GEVE-VENTILATOR/Mechanical-Design-/Schematics/Capture1.PNG

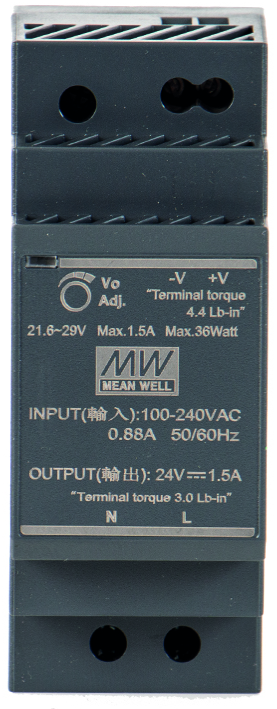
Schematics/Capture1.PNG
