GEVE-VENTILATOR/Mechanical-Design-/Schematics/arduino-a000066.jpg

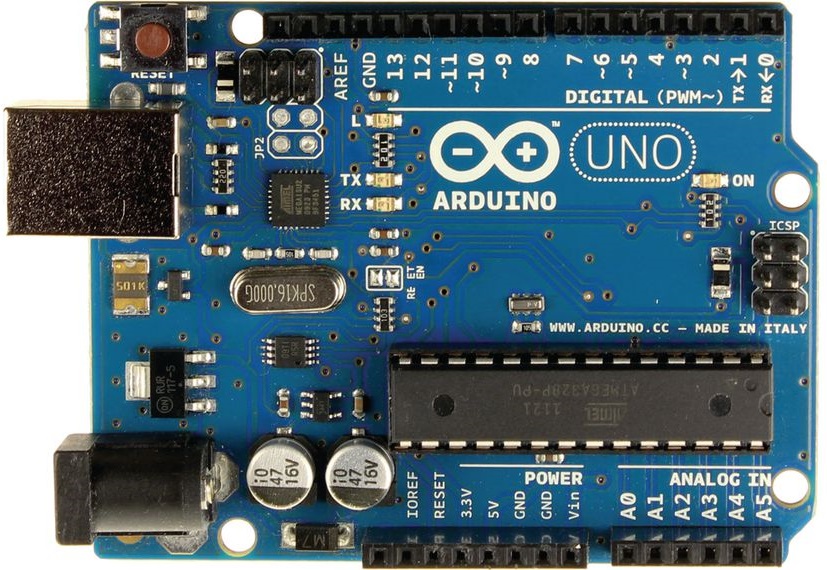
Schematics/arduino-a000066.jpg
