GEVE-VENTILATOR/Mechanical-Design-/README.md

# Mechanical-Design-
This space contains the CAD design of the GEVE Ventilator Project

Here you can find the CAD drawings and the files for the 3D printed parts
