GEVE-VENTILATOR/Mechanical-Design-/CAO/Dossier partage/rob-ceve-p20.pdf

3

317,5

367,5

Plaque de base | Echelle 1:2 | | Dessiné | K. Polte
| | | Date | 05-May-21
| | | Classe
| Fichier de mise en plan | | | ROB-CEVE-P20
hepia | Fichier du modèle | | | ROB-CEVE-P20
| Matière | PMMA
N° de Feuille | 1 | Nbr tot Feuilles | 1 | N° dessin | ROB-CEVE-P20 | Format | A3
