GEVE-VENTILATOR/Mechanical-Design-/CAO/Dossier partage/rob-ceve-p24.pdf

3

5,1

317,5

187,5

5,1

Plaque latérale simple | Echelle 1:2 | | Dessiné | K. Polte
| | | Date | 05-May-21
| | | Classe
| Fichier de mise en plan | | | ROB-CEVE-P24
hepia | Fichier du modèle | | | ROB-CEVE-P24
| Matière | PMMA
N° de Feuille | 1 | Nbr tot Feuilles | 1 | N° dessin | ROB-CEVE-P24 | Format | A4
