GEVE-VENTILATOR/Mechanical-Design-/Schematics/Capture3.PNG

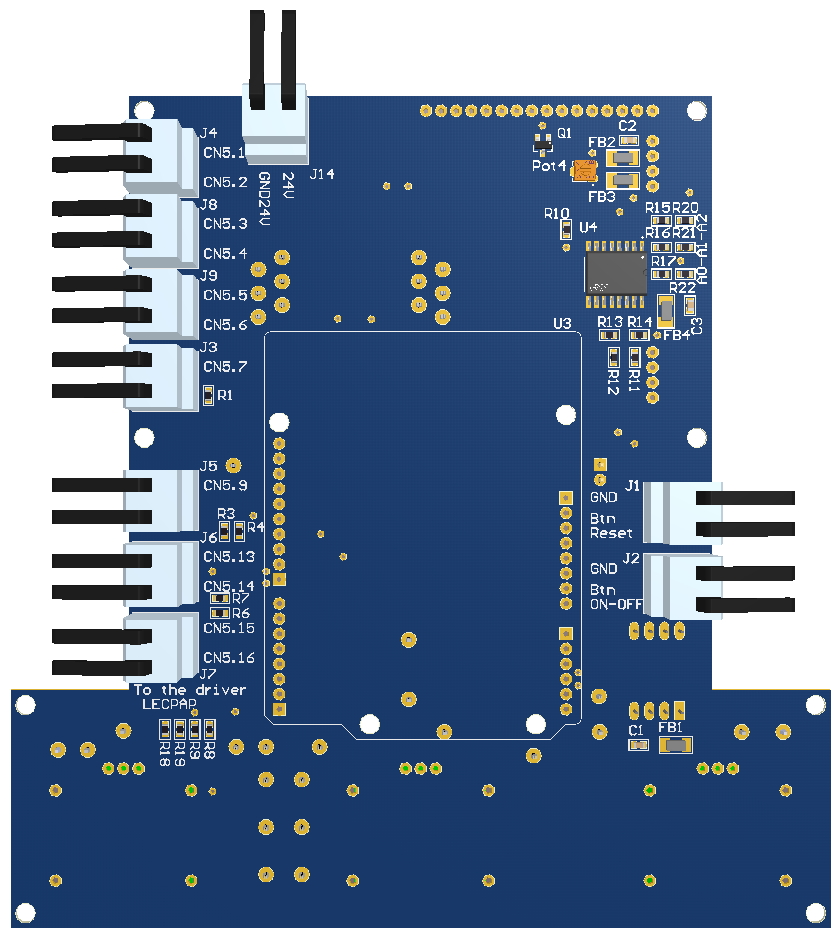
Schematics/Capture3.PNG
