GEVE-VENTILATOR/Mechanical-Design-/Schematics/Capture6.PNG

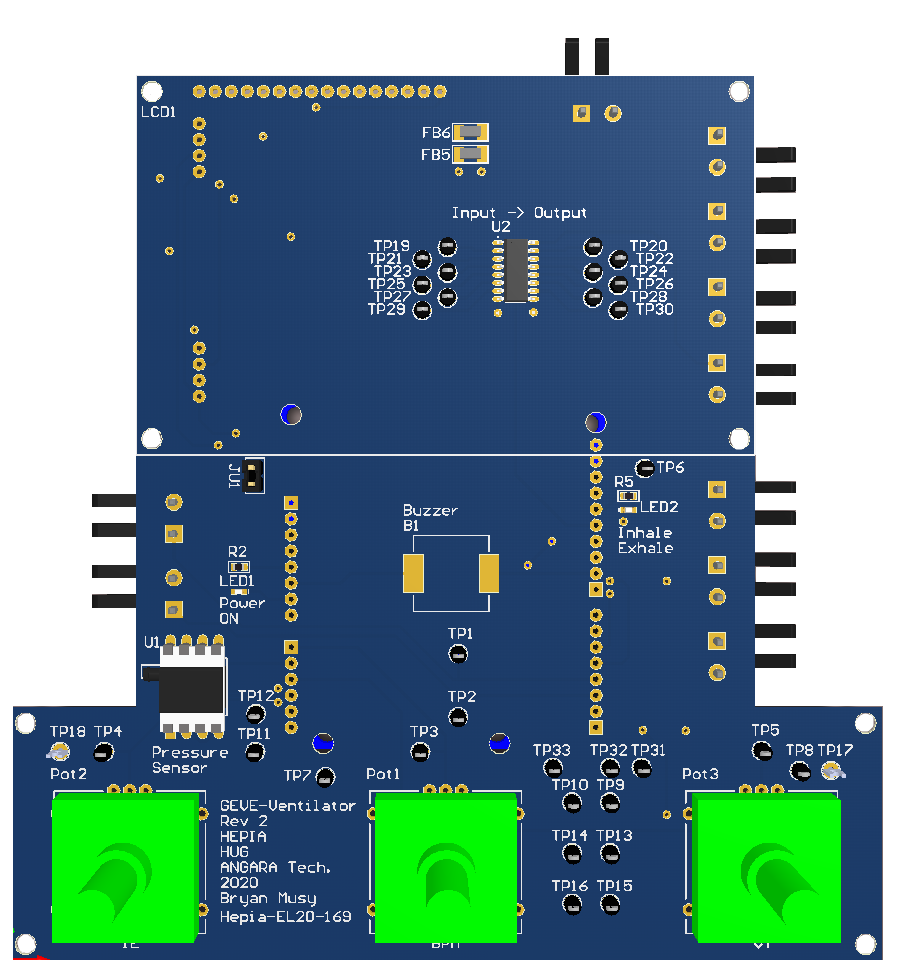
Schematics/Capture6.PNG
