GEVE-VENTILATOR/Mechanical-Design-/Schematics/Capture54.PNG

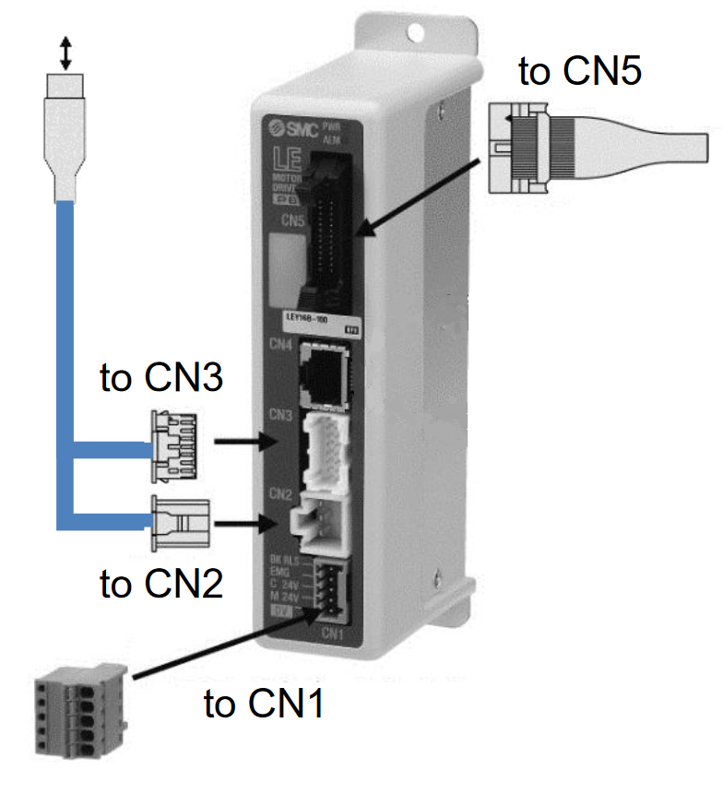
Schematics/Capture54.PNG
