GEVE-VENTILATOR/Mechanical-Design-/Schematics/Capture.PNG

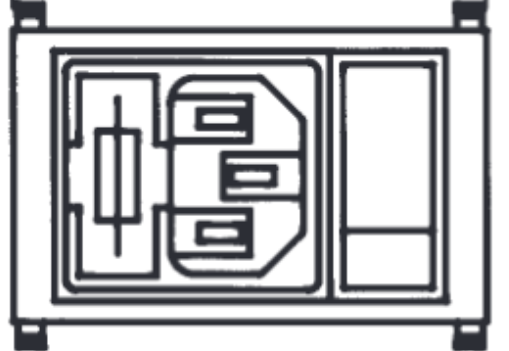
Schematics/Capture.PNG
