GEVE-VENTILATOR/Mechanical-Design-/Schematics/HTB1hoBYaKALL1JjSZFjq6ysqXXaX.jpg

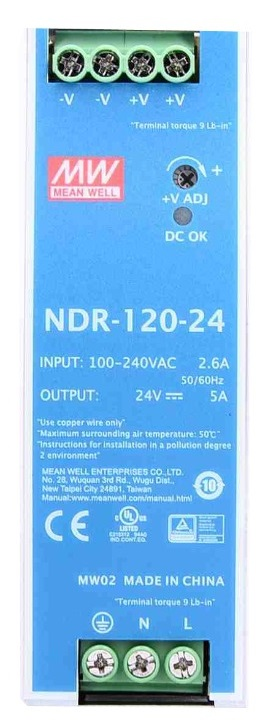
Schematics/HTB1hoBYaKALL1JjSZFjq6ysqXXaX.jpg
