GEVE-VENTILATOR/Mechanical-Design-/Schematics/IDEC-YW1B-A2E10S-30102645-01.jpg

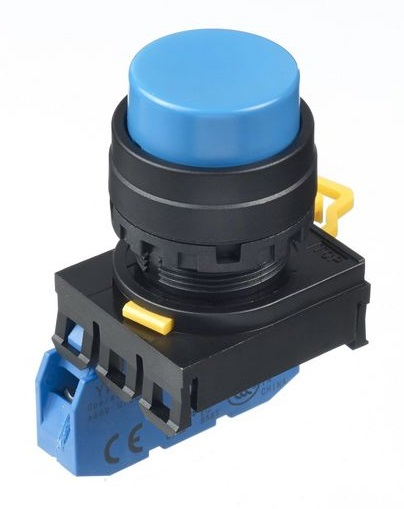
Schematics/IDEC-YW1B-A2E10S-30102645-01.jpg
