GEVE-VENTILATOR/Mechanical-Design-/Schematics/IDEC-YW1L-A2E10Q4G-30102687-01.jpg

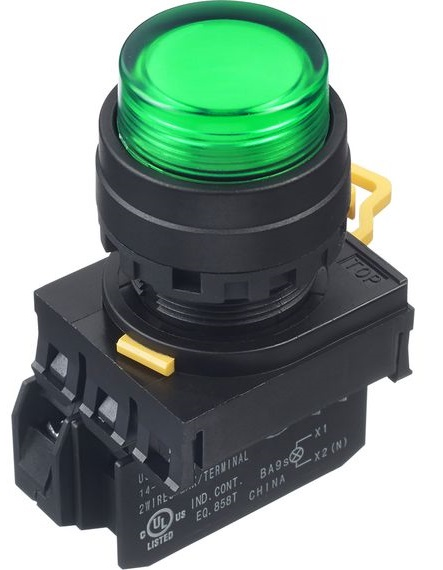
Schematics/IDEC-YW1L-A2E10Q4G-30102687-01.jpg
