GEVE-VENTILATOR/Mechanical-Design-/ListeofComponents.xlsx

Bill of Material for
On 09.11.2020 at 09:12:04
Comment | Pattern | Quantity | Components | Description | Unitary price | Prix | Website | Ref | Link
0R | RES_0603 | 5 | R11, R12, R20, R21, R22 | Thin Film Resistor, Boite Labo 0603, Jumper 0R | 0.09 | 0.45 | Digikey | 311-0.0HRTR-ND | https://www.digikey.ch/product-detail/fr/yageo/RC0603FR-070RL/311-0-0HRTR-ND/1304008
10K | PCW1J-B28-BAB103L | 3 | Pot1, Pot2, Pot3 |  | 4.89 | 14.67 | Digikey | PCW1J-B28-BAB103L-ND | https://www.digikey.ch/products/fr?keywords=PCW1J-B28-BAB103L-ND
10k | RES_0603 | 3 | R15, R16, R17 | Thin Film Resistor, Boite Labo 0603, 10k 1% | 0.09 | 0.27 | Digikey | RNCP0603FTD10K0CT-ND | https://www.digikey.ch/product-detail/fr/stackpole-electronics-inc/RNCP0603FTD10K0/RNCP0603FTD10K0CT-ND/2240478
10k | Trimpot-3313-J1 | 1 | Pot4 | TrimPot SMD 1 Tour 10k 3mm | 1.80 | 1.80 | Digikey | 3313J-103ECT-ND | https://www.digikey.ch/products/fr?keywords=3313J-103ECT-ND
1uF | CAP_0603H0.8 | 3 | C1, C2, C3 | Boite Labo 0603: Ceramic Cap, 1uF, 10%, 50V, CAP_0603H0.8 | 0.09 | 0.27 | Digikey | 738-CML0603Y5V104ZT50VCT-ND | https://www.digikey.ch/product-detail/fr/stackpole-electronics-inc/CML0603Y5V104ZT50V/738-CML0603Y5V104ZT50VCT-ND/10660166
22k | RES_0603 | 4 | R3, R6, R8, R18 | Thin Film Resistor, Boite Labo 0603, 22k 1% | 0.09 | 0.36 | Digikey | RMCF0603FG22K0CT-ND | https://www.digikey.ch/product-detail/fr/stackpole-electronics-inc/RMCF0603FG22K0/RMCF0603FG22K0CT-ND/6053828
3k3 | RES_0603 | 2 | R2, R5 | Thin Film Resistor, Boite Labo 0603, 3k3 1% | 0.09 | 0.18 | Digikey | 311-3.30KHRCT-ND | https://www.digikey.ch/product-detail/fr/yageo/RC0603FR-073K3L/311-3-30KHRCT-ND/730073
4k7 | RES_0603 | 3 | R10, R13, R14 | Thin Film Resistor, Boite Labo 0603, 4k7 1% | 0.09 | 0.27 | Digikey | RMCF0603FT4K70CT-ND | https://www.digikey.ch/product-detail/fr/stackpole-electronics-inc/RMCF0603FT4K70/RMCF0603FT4K70CT-ND/1943033
5k6 | RES_0603 | 5 | R1, R4, R7, R9, R19 | Thin Film Resistor, Boite Labo 0603, 5k6 1% | 0.09 | 0.45 | Digikey | RMCF0603FT5K60CT-ND | https://www.digikey.ch/products/fr?keywords=RMCF0603FT5K60CT-ND
661004152022 |  | 2 | J11, J12 | Connecteur 90 4 fils | 0.68 | 1.36 | Digikey | 732-14127-5-ND | https://www.digikey.ch/products/fr?keywords=661004152022
Connect Alimentation |  | 1 | J13 | Connecteurs d'alimentation Socle | 10.53 | 10.53 | Digikey | 708-1880-ND | https://www.digikey.ch/product-detail/fr/bulgin/BZV01-Z0000-01/708-1880-ND/3961661
ARDUINO_UNO_REV3 | ARDUINO_A000066 | 1 | U3 |  | 20.02 | 20.02 | Digikey | 1050-1024-ND | https://www.digikey.ch/product-detail/fr/arduino/A000066/1050-1024-ND/2784006
AST0250204 | AST0250204 | 9 | J1, J2, J3, J4, J5, J6, J7, J8, J9 |  | 1.50 | 13.50 | Digikey | 1849-1111-ND | https://www.digikey.ch/products/fr?keywords=AST0250204
BC817-25,215 | SOT23-3 | 1 | Q1 | Bipolar NPN, General Purpose, 45V,100MHz, 500mA | 0.13 | 0.13 | Digikey | 1727-2918-1-ND | https://www.digikey.ch/product-detail/fr/nexperia-usa-inc/BC817-25-215/1727-2918-1-ND/763457
BLM31AJ601SN1L | FERRITE_1206_1.1 | 6 | FB1, FB2, FB3, FB4, FB5, FB6 | Chip Ferrite Bead, 1206, 200mA, DCRes=0.90ohm, 100MHz_Res=600ohm | 0.28 | 1.68 | Digikey | 490-11053-1-ND | https://www.digikey.ch/product-detail/fr/murata-electronics/BLM31AJ601SH1L/490-11053-1-ND/5332936
CMT-1203-SMT-TR | CMT-1203-SMT-TR | 1 | B1 |  | 1.64 | 1.64 | Digikey | 102-2197-1-ND | https://www.digikey.ch/product-detail/fr/cui-devices/CMT-1203-SMT-TR/102-2197-1-ND/2364649
Connecteur Male 36 pins |  | 1 | J10 |  | 1.97 | 1.97 | Distrelec | 143-83-922 | https://www.distrelec.ch/fr/890-droit-male-barrette-de-circuit-imprime-trou-traversant-rangees-36-contacts-54mm-pas-preci-dip-890-18-036-10-808/p/14383922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
Fuze |  | 1 | F1 | Fusible 250V 1.25A | 0.70 | 0.70 | Distrelec | 133-52-296 | https://www.distrelec.ch/fr/fusible-20-25a-250v-decalage-temporel-eska-521-018/p/13352296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
LCD2004A | LCD2004 | 1 | LCD1 |  | 8.34 | 8.34 | Banggood | LCD2004 | https://www.banggood.com/Geekcreit-IIC-I2C-2004-204-20-x-4-Character-LCD-Display-Screen-Module-Blue-Geekcreit-for-Arduino-products-that-work-with-official-Ard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
PCF8574T/3,518 | FP-SOT162-1-MFG | 1 | U4 | IC I/O EXPANDER I2C 8B 16SOIC | 1.31 | 1.31 | Digikey | 568-1077-1-ND | https://www.digikey.ch/product-detail/fr/nxp-usa-inc/PCF8574T-3-518/568-1077-1-ND/735791
PREC002SAAN-RC | Jumper_2P_P2.54 | 1 | JU1 | CONN HEADER .100 SNGL STR 2POS" | 0.05 | 0.05 | Digikey | S1012EC-02-ND | https://www.digikey.ch/products/fr?keywords=S1012EC-02-ND
SM0603HCL | LED_0603-12 | 2 | LED1, LED2 | LED red smd 0603 2 mA | 0.57 | 1.14 | Digikey | 492-2524-1-ND | https://www.digikey.ch/product-detail/fr/bivar-inc/SM0603HCL/492-2524-1-ND/9695480
SSCDRNN160MDAA5 | DIP8 SSC Series | 1 | U1 |  | 30.96 | 30.96 | Digikey | 480-5448-ND | https://www.digikey.ch/products/fr?keywords=SSCDRNN160MDAA5
TP_HOOK | TP_HOOK | 31 | TP1, TP2, TP3, TP4, TP5, TP6, TP7, TP8, TP9, TP10, TP11, TP12, TP13, TP14, TP15, TP16, TP19, TP20, TP21, TP22, TP23, TP24, TP25, TP26, TP27, TP28, TP29, TP30, TP31, TP32, TP33 | Test Point Hook Type |  | 0.00
TP_PLATE | TP_PLATE | 2 | TP17, TP18 | Test Point Plate Type (for GND) |  | 0.00
ULN2003ADR | D0016A_M | 1 | U2 | High-Voltage, High-Current Darlington Transistor Array, 0.5 A, 50 V, -20 to 70 degC, 16-Pin SOIC (D), Green (RoHS & no Sb/Br), Tape and Reel | 0.47 | 0.47 | Digikey | 296-1368-1-ND | https://www.digikey.ch/product-detail/fr/texas-instruments/ULN2003ADR/296-1368-1-ND/404968
YW1B-M2E10G |  | 1 | Btn2 | Bouton vert | 9.75 | 9.75 | Distrelec | 301-02-661 | https://www.distrelec.ch/fr/bouton-poussoir-10-600-idec-yw1b-m2e10g/p/30102661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
YW1B-M2E10S |  | 1 | Btn1 | Bouton bleu | 9.75 | 9.75 | Distrelec | 301-02-663 | https://www.distrelec.ch/fr/bouton-poussoir-10-600-idec-yw1b-m2e10s/p/30102663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
3801/04 |  | 1 | Cab1 | Cables plats 4 fils | 0.39 | 0.39 | Digikey | 301-02-663 | https://www.digikey.ch/product-detail/fr/3m/3801-04/3M156838-1-ND/8256317
LECPAP1D |  | 1 | Drive1 | Driver step motor | 265.00 | 265.00 | SMC | LECPAP1D-LEFS25B-200 | https://www.smcpneumatics.com/LECPAP1D-LEFS25B-200.html
NDR-120-24 |  | 1 | Alim1 | Alimentation AC/DC | 32.51 | 32.51 | Digikey | 1866-3518-ND | https://www.digikey.ch/products/fr?keywords=1866-3518-ND
HDR-30-24 |  | 1 | Alim2 | Alimentation DC/DC | 17.21 | 17.21 | Digikey | 1866-2244-ND | https://www.digikey.ch/products/fr?keywords=1866-2244-ND
Pipe Silicone Versilic |  | 1 |  | silicon pipe 1-2 meter | 94.45 | 94.45 | milian | 260001 | https://www.milian.ch/frontoffice/article/260001
Connector Luer |  | 1 |  | Connector Luer | 1.15 | 1.15 | milan | 533057 | https://www.milian.ch/frontoffice/article/533057
 |  |  |  |  |  | 542.73
