GEVE-VENTILATOR/Mechanical-Design-/CAO/Dossier partage/rob-ceve-p32.stp

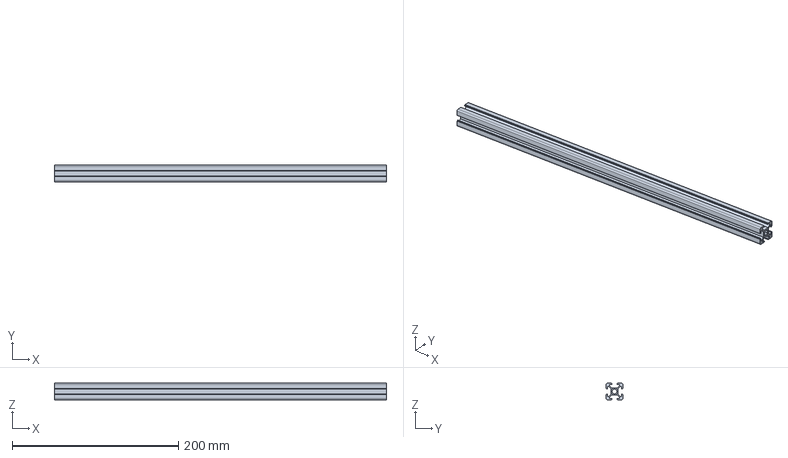
[picture p10: CAD file, 2021-05-17]
CAO/Dossier partage/rob-ceve-p32.stp
400.0 x 20.0 x 20.0 mm
