GEVE-VENTILATOR/Mechanical-Design-/CAO/Respirateur V2/rob-ceve-p31.stp

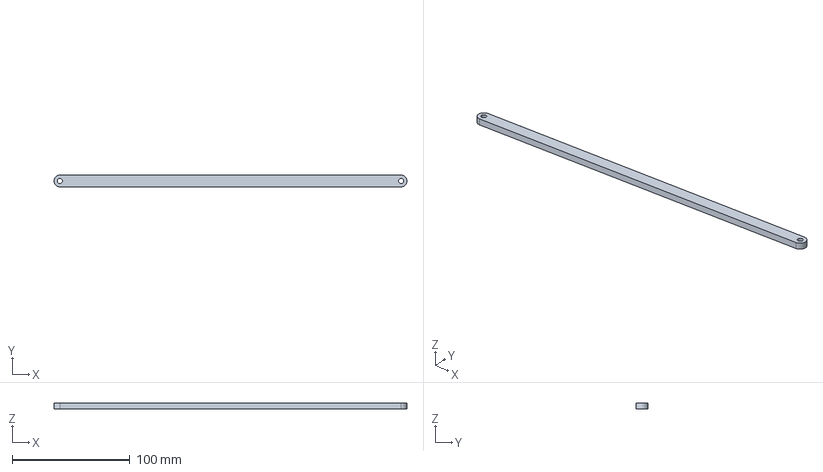
[picture p11: CAD file, 2021-05-17]
CAO/Respirateur V2/rob-ceve-p31.stp
300.0 x 10.0 x 5.00 mm
