GEVE-VENTILATOR/Mechanical-Design-/CAO/sscdrnn160mdaa5.stp

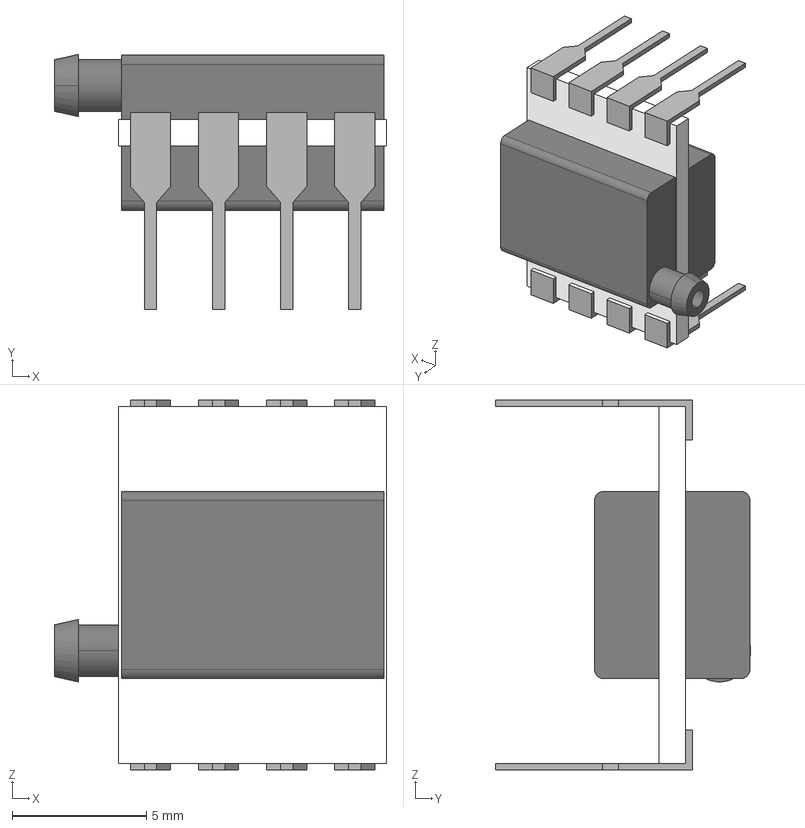
[picture p12: CAD file, 2021-05-17]
CAO/sscdrnn160mdaa5.stp
12.4 x 9.53 x 13.8 mm
