GEVE-VENTILATOR/Mechanical-Design-/CAO/Respirateur V2/rob-ceve-p20.stp

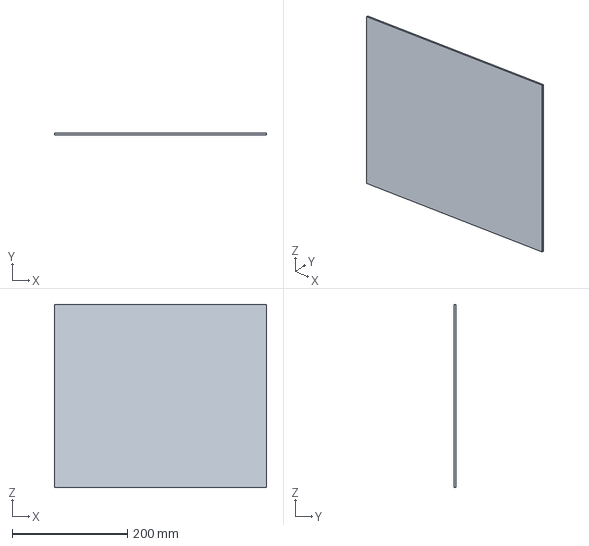
[picture p13: CAD file, 2021-05-17]
CAO/Respirateur V2/rob-ceve-p20.stp
367.5 x 3.00 x 317.5 mm
