GEVE-VENTILATOR/Mechanical-Design-/CAO/Dossier partage/rob-ceve-p08.stp

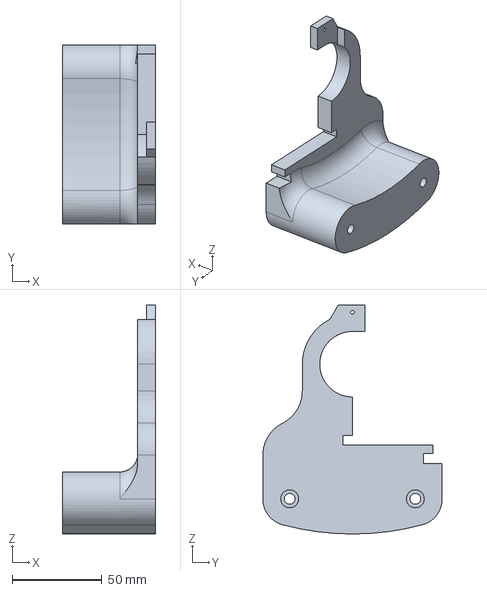
[picture p14: CAD file, 2021-05-17]
CAO/Dossier partage/rob-ceve-p08.stp
52.0 x 100.0 x 127.6 mm
