GEVE-VENTILATOR/Mechanical-Design-/CAO/lcd2004v2.stp

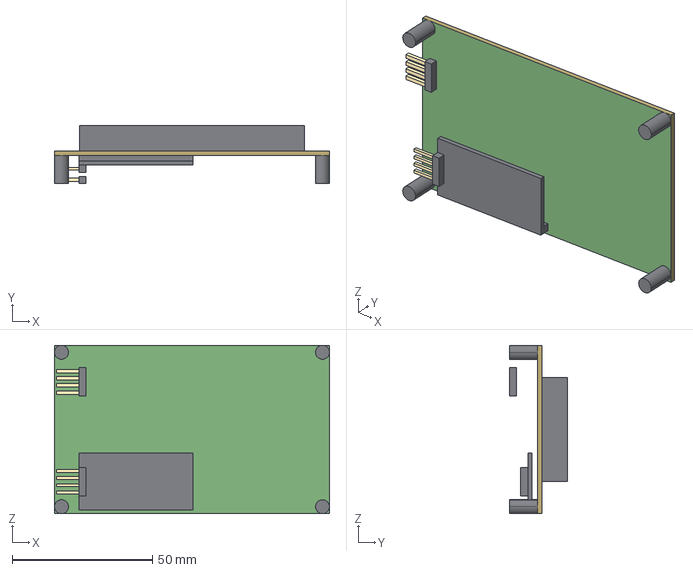
[picture p15: CAD file, 2021-05-17]
CAO/lcd2004v2.stp
98.0 x 20.6 x 60.0 mm
