GEVE-VENTILATOR/Mechanical-Design-/CAO/Respirateur V2/rob-ceve-p25-v2.stl

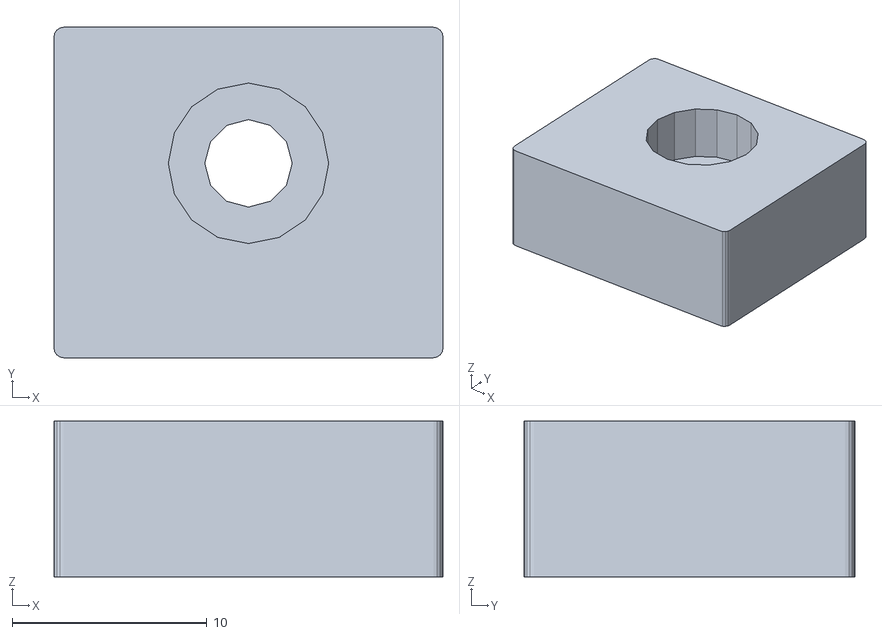
[picture p16: CAD file, 2021-05-17]
CAO/Respirateur V2/rob-ceve-p25-v2.stl
20.0 x 17.0 x 8.00
