GEVE-VENTILATOR/Mechanical-Design-/CAO/Dossier partage/rob-ceve-p09.stp

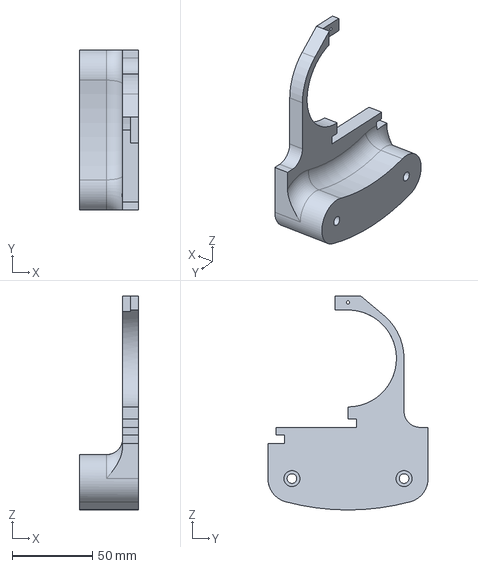
[picture p17: CAD file, 2021-05-17]
CAO/Dossier partage/rob-ceve-p09.stp
37.0 x 100.0 x 133.6 mm
