GEVE-VENTILATOR/Mechanical-Design-/CAO/Respirateur V2/rob-ceve-p34.stp

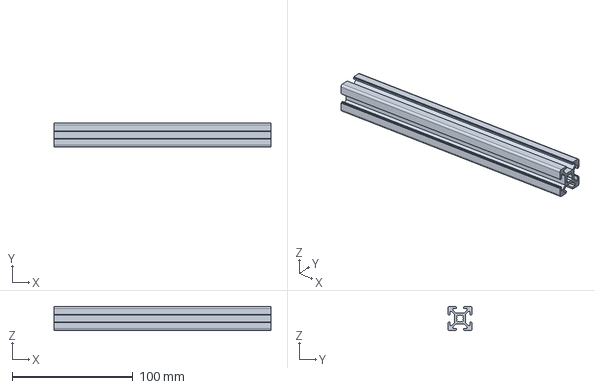
[picture p18: CAD file, 2021-05-17]
CAO/Respirateur V2/rob-ceve-p34.stp
180.0 x 20.0 x 20.0 mm
