GEVE-VENTILATOR/Mechanical-Design-/CAO/rob-ceve-p23.stp

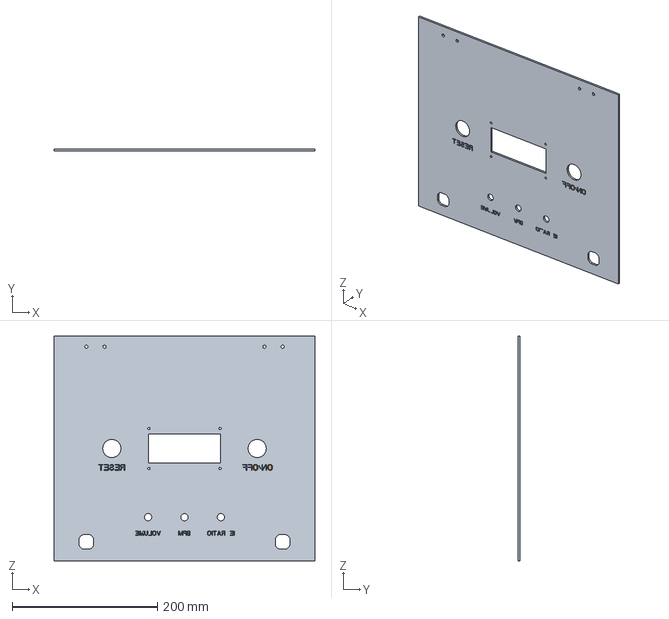
[picture p19: CAD file, 2021-05-17]
CAO/rob-ceve-p23.stp
359.0 x 3.00 x 309.0 mm
