GEVE-VENTILATOR/Mechanical-Design-/CAO/Dossier partage/rob-ceve-p10.stp

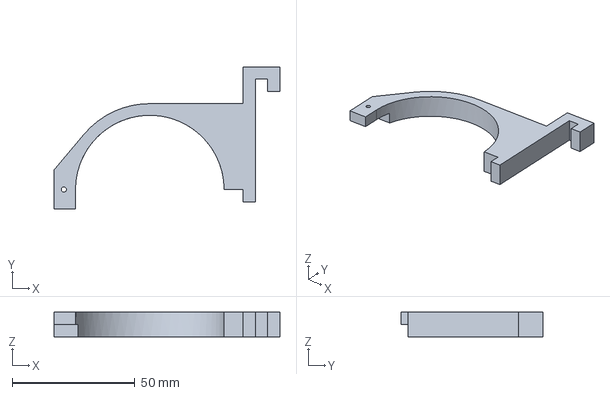
[picture p20: CAD file, 2021-05-17]
CAO/Dossier partage/rob-ceve-p10.stp
92.0 x 58.0 x 10.0 mm
