GEVE-VENTILATOR/Mechanical-Design-/CAO/LCD2004.stp

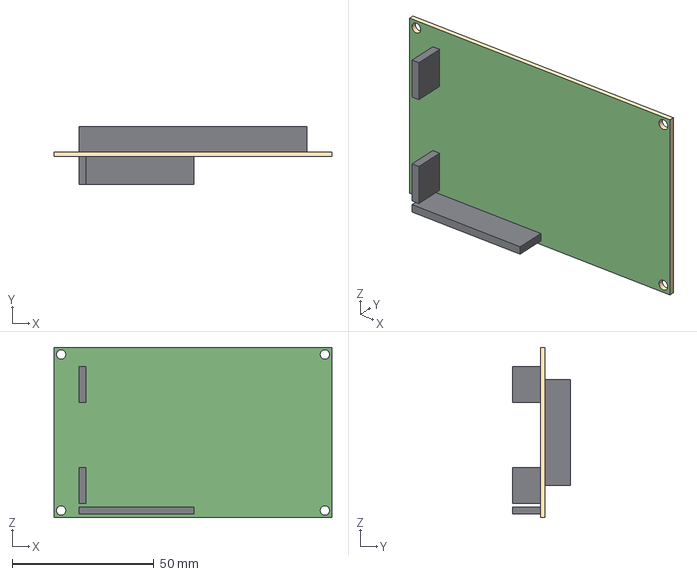
[picture p21: CAD file, 2021-05-17]
CAO/LCD2004.stp
98.0 x 20.6 x 60.0 mm
