GEVE-VENTILATOR/Mechanical-Design-/CAO/Respirateur V2/rob-ceve-p28.stp

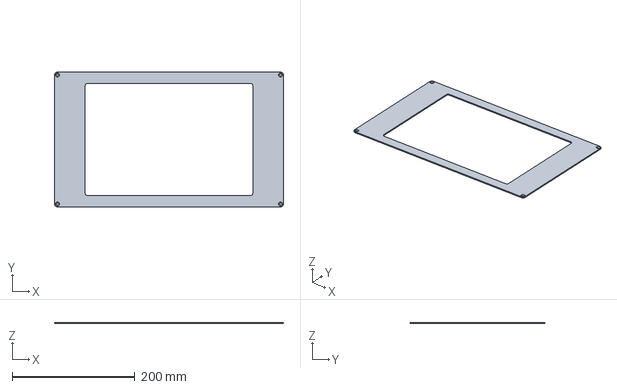
[picture p22: CAD file, 2021-05-17]
CAO/Respirateur V2/rob-ceve-p28.stp
373.0 x 220.0 x 2.00 mm
