GEVE-VENTILATOR/Mechanical-Design-/CAO/Dossier partage/rob-ceve-p11.stp

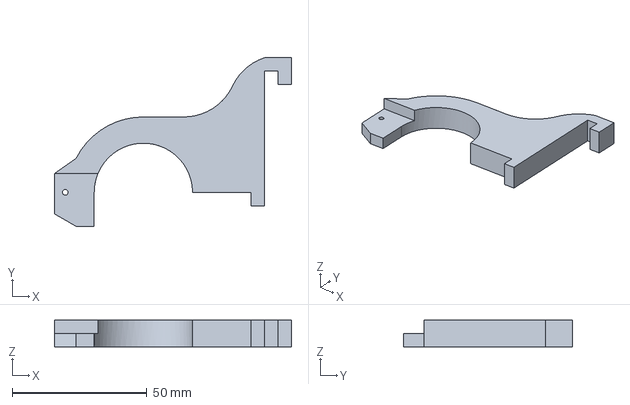
[picture p23: CAD file, 2021-05-17]
CAO/Dossier partage/rob-ceve-p11.stp
88.0 x 62.6 x 10.0 mm
