GEVE-VENTILATOR/Mechanical-Design-/CAO/Respirateur V2/rob-ceve-p26.stp

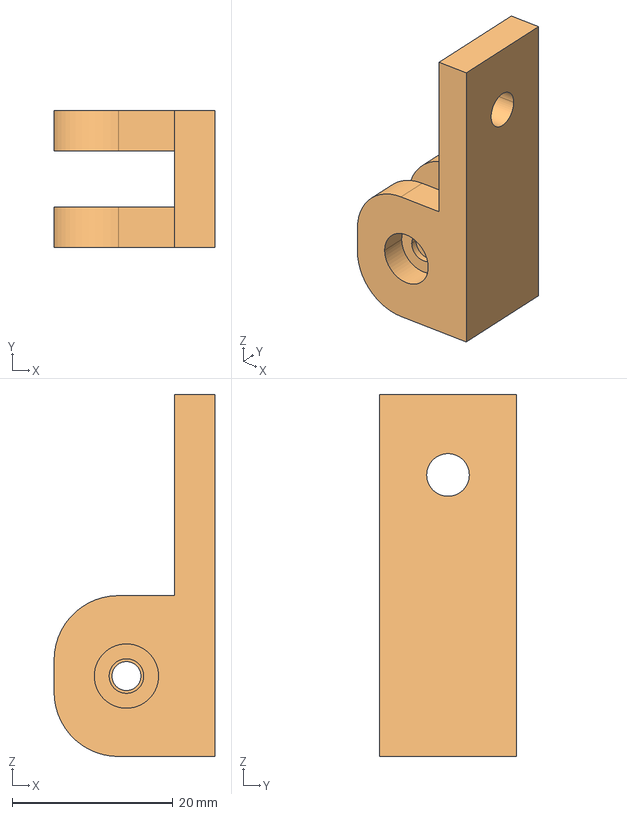
[picture p24: CAD file, 2021-05-17]
CAO/Respirateur V2/rob-ceve-p26.stp
20.0 x 17.0 x 45.0 mm
