GEVE-VENTILATOR/Mechanical-Design-/CAO/Dossier partage/rob-ceve-a01.stp

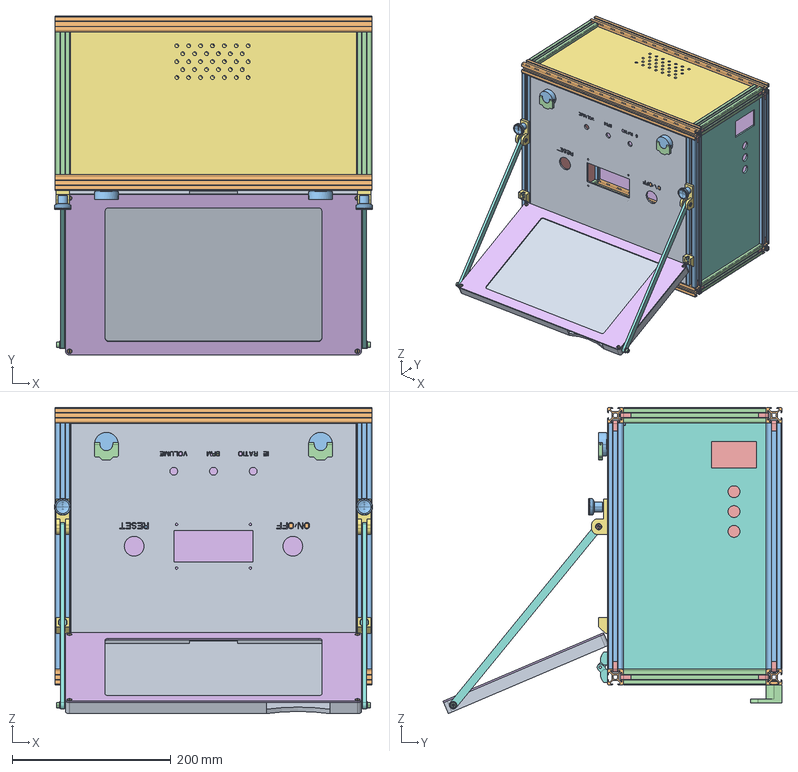
[picture p25: CAD file, 2021-05-17]
CAO/Dossier partage/rob-ceve-a01.stp
401.0 x 427.2 x 385.9 mm
ROB-CEVE-P32 x 4
ROB-CEVE-P33 x 4
ROB-CEVE-P34 x 4
INNER_BRACKET_6 x 16
ROB-CEVE-P20
ROB-CEVE-P21 x 2
ROB-CEVE-P22
ROB-CEVE-P23
_HINGES_CFTX_40_SH-4_1_0_ x 4
_HINGES_CFTX_40_SH-4_2_0_ x 2
_LATCHES_WITH_FOLD-AWAY_KNOB-31 x 2
_LATCHES_WITH_FOLD-AWAY_KNOB-37 x 2
_LATCHES_WITH_FOLD-AWAY_KNOB-43 x 2
ROB-CEVE-P24
ROB-CEVE-P25 x 4
ROB-CEVE-P26 x 2
ROB-CEVE-P31 x 2
ROB-CEVE-P27
SLIDING_BLOCK x 6
RDL_M_4_3X9X0_85 x 10
VIS_T_CY_6P_M4X16 x 2
VIS_T_CY_6P_M4X12 x 2
ROB-CEVE-P28
ROB-CEVE-P30 x 2
VIS_T_CO_6P_M5X8 x 2
RDL_5_3X10X1 x 2
VIS_CO_M3X8 x 4
EKK_21_P_M5X10_C1 x 2
ROB-CEVE-P35 x 2
VIS_T_CY_6P_M5X20 x 2
