GEVE-VENTILATOR/Mechanical-Design-/CAO/Respirateur V2/ELESA-CFTX_40_SH_4.stp

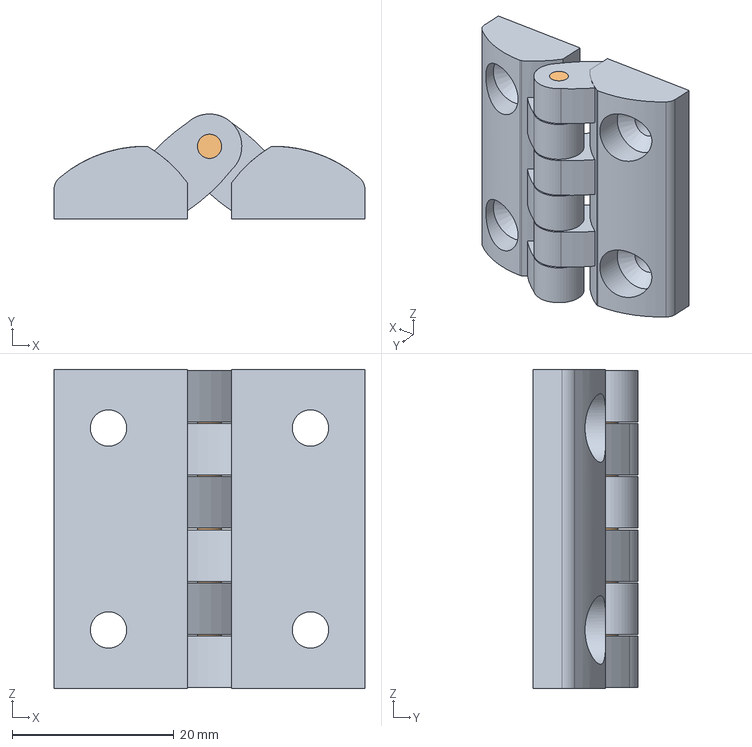
[picture p26: CAD file, 2021-05-17]
CAO/Respirateur V2/ELESA-CFTX_40_SH_4.stp
38.5 x 13.0 x 39.5 mm
_Hinges CFTX.40 SH-4_1(0) x 2
_Hinges CFTX.40 SH-4_2(0)
