GEVE-VENTILATOR/Mechanical-Design-/CAO/Respirateur V2/rob-ceve-p33.stp

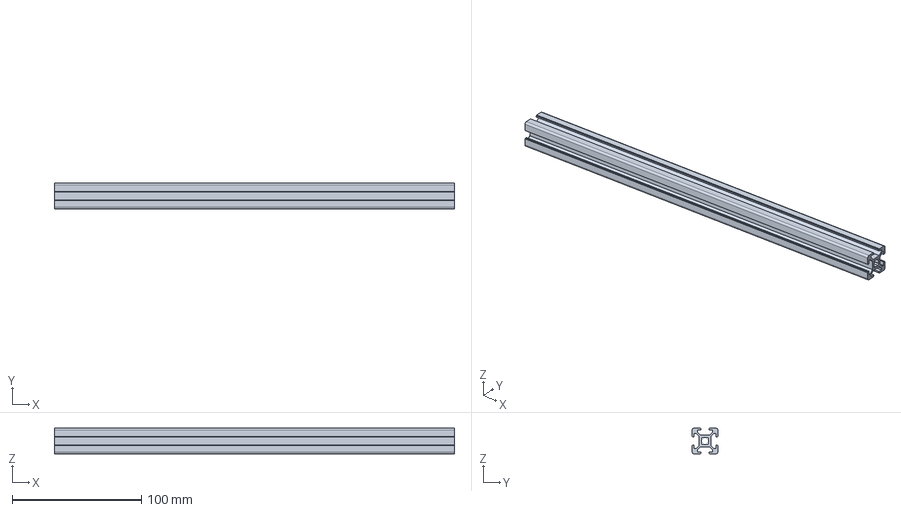
[picture p27: CAD file, 2021-05-17]
CAO/Respirateur V2/rob-ceve-p33.stp
310.0 x 20.0 x 20.0 mm
