GEVE-VENTILATOR/Mechanical-Design-/CAO/Dossier partage/rob-ceve-p21.stp

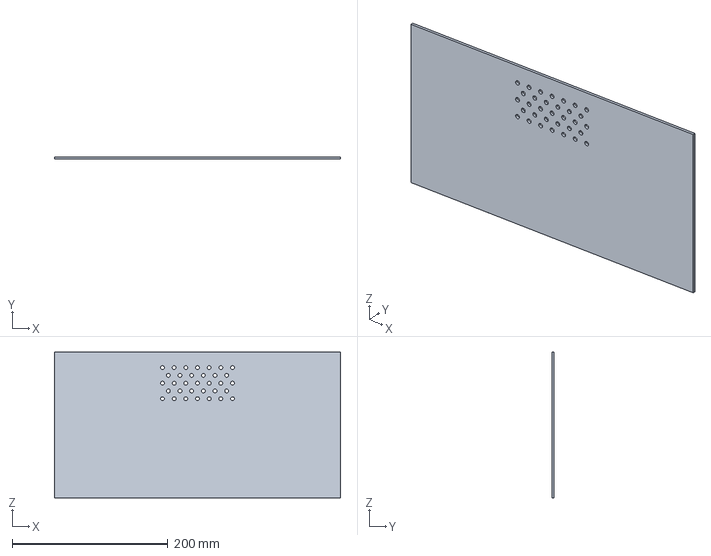
[picture p28: CAD file, 2021-05-17]
CAO/Dossier partage/rob-ceve-p21.stp
367.5 x 3.00 x 187.5 mm
