GEVE-VENTILATOR/Mechanical-Design-/CAO/Respirateur V2/ELESA_CMT_32-18_AE_V0.stp

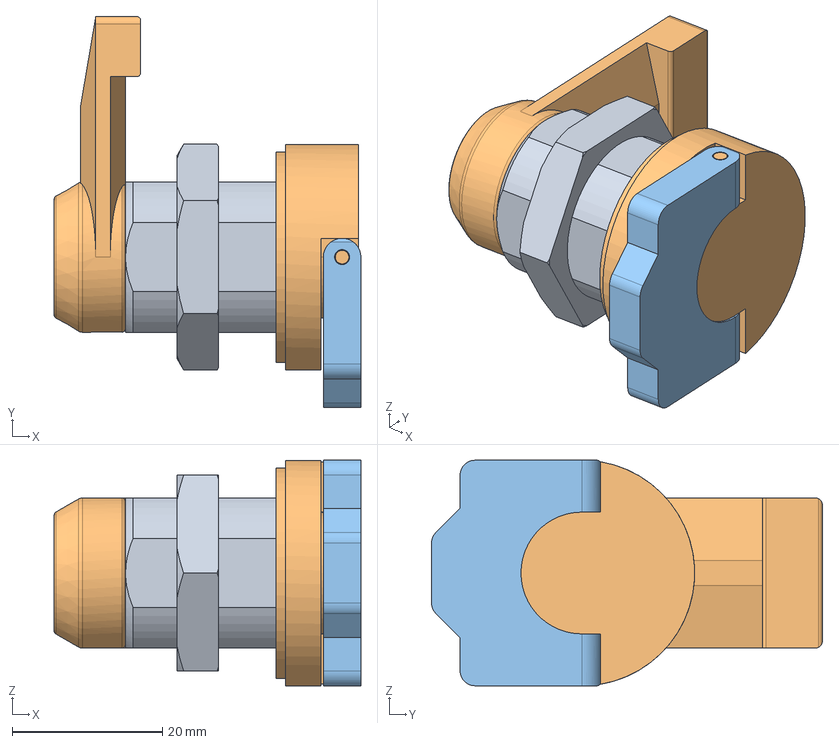
[picture p29: CAD file, 2021-05-17]
CAO/Respirateur V2/ELESA_CMT_32-18_AE_V0.stp
40.8 x 52.0 x 30.0 mm
_Latches with fold-away knob CMT.32-18 AE-V0-2
_Latches with fold-away knob CMT.32-18 AE-V0-1
_Latches with fold-away knob CMT.32-18 AE-V0-3
