GEVE-VENTILATOR/Mechanical-Design-/CAO/Respirateur V2/rob_ceve_p40.stl

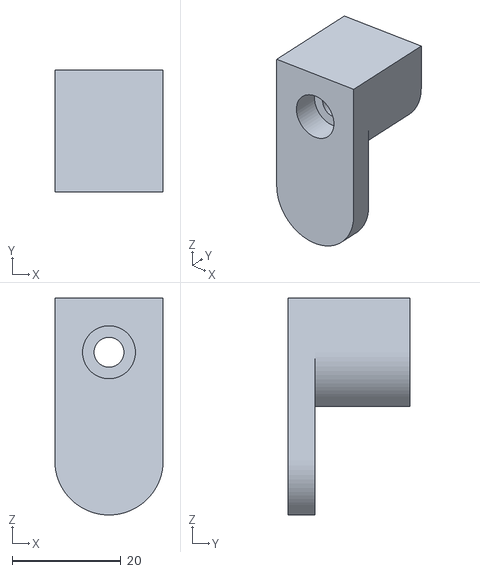
[picture p30: CAD file, 2021-05-17]
CAO/Respirateur V2/rob_ceve_p40.stl
20.0 x 22.5 x 40.0
