GEVE-VENTILATOR/Mechanical-Design-/CAO/Dossier partage/rob-ceve-p24.stp

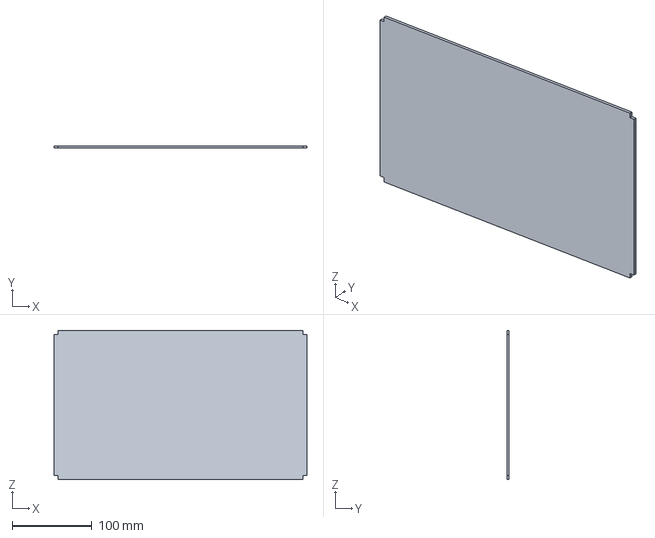
[picture p31: CAD file, 2021-05-17]
CAO/Dossier partage/rob-ceve-p24.stp
317.5 x 3.00 x 187.5 mm
