GEVE-VENTILATOR/Mechanical-Design-/CAO/Respirateur V2/SLIDING_BLOCK.stp

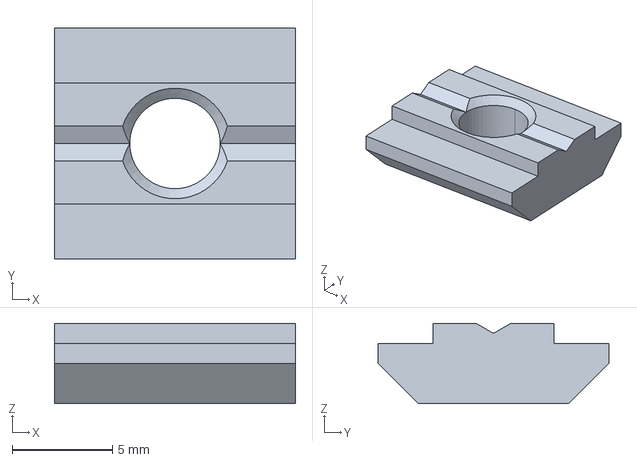
[picture p32: CAD file, 2021-05-17]
CAO/Respirateur V2/SLIDING_BLOCK.stp
12.0 x 11.5 x 4.00 mm
