GEVE-VENTILATOR/Mechanical-Design-/CAO/Respirateur V2/CLAMPING_LEVER.stp

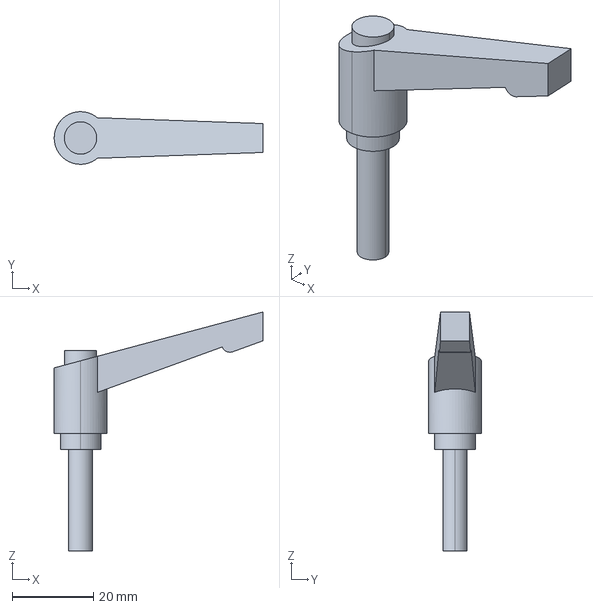
[picture p33: CAD file, 2021-05-17]
CAO/Respirateur V2/CLAMPING_LEVER.stp
51.5 x 13.0 x 59.0 mm
