GEVE-VENTILATOR/Mechanical-Design-/CAO/Dossier partage/rob-ceve-p27.stp

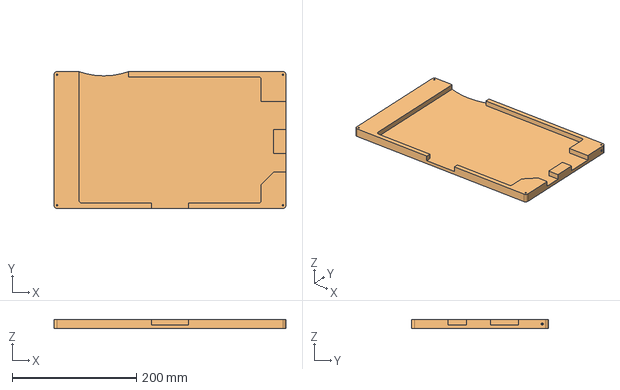
[picture p34: CAD file, 2021-05-17]
CAO/Dossier partage/rob-ceve-p27.stp
373.0 x 220.0 x 15.0 mm
