GEVE-VENTILATOR/Mechanical-Design-/CAO/Dossier partage/rob-ceve-p30.stp

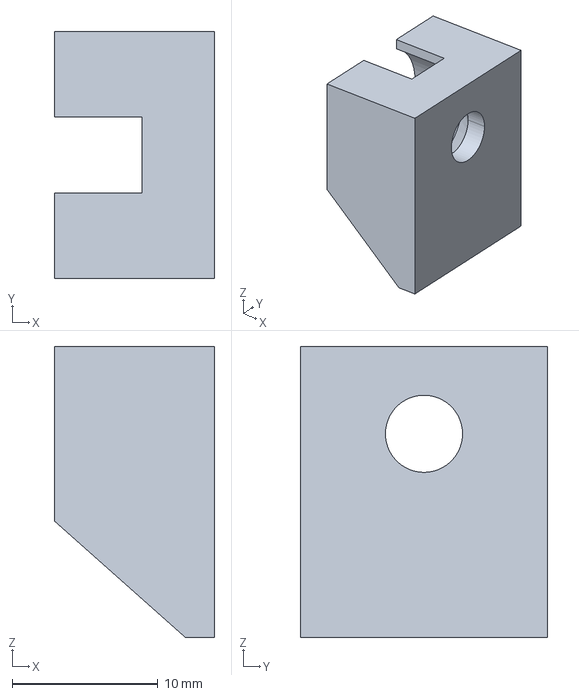
[picture p35: CAD file, 2021-05-17]
CAO/Dossier partage/rob-ceve-p30.stp
11.0 x 17.0 x 20.0 mm
