GEVE-VENTILATOR/Mechanical-Design-/CAO/Respirateur V2/rob-ceve-p23_v2.dxf

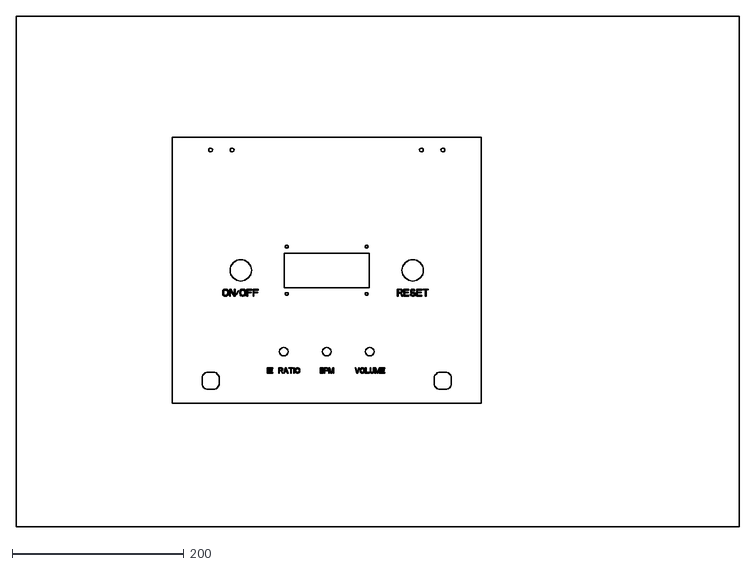
[picture p36: CAD file, 2021-05-17]
CAO/Respirateur V2/rob-ceve-p23_v2.dxf
841.0 x 594.0
