GEVE-VENTILATOR/Mechanical-Design-/CAO/Dossier partage/rob-ceve-p02.stp

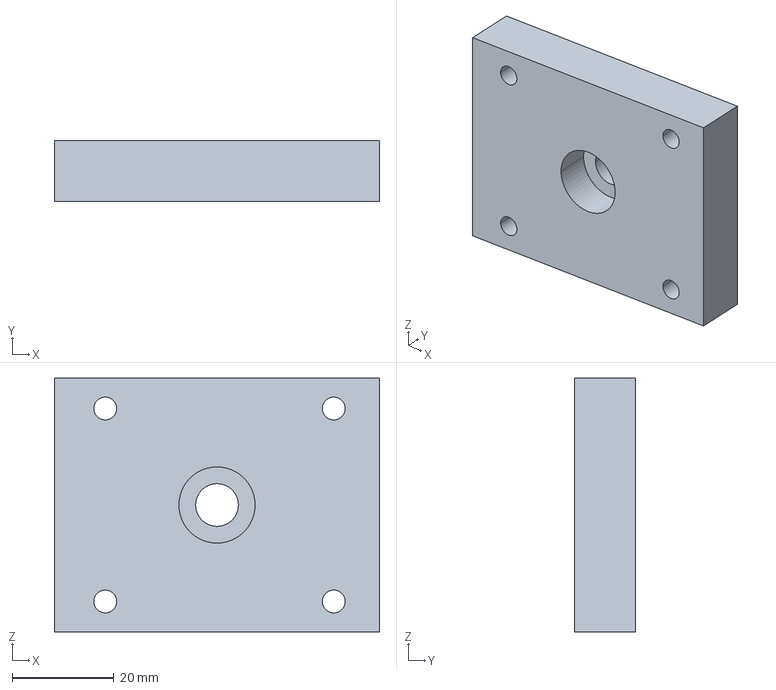
[picture p37: CAD file, 2020-04-15]
CAO/Dossier partage/rob-ceve-p02.stp
64.0 x 12.0 x 50.0 mm
