GEVE-VENTILATOR/Mechanical-Design-/CAO/Dossier partage/rob-ceve-a00.stp

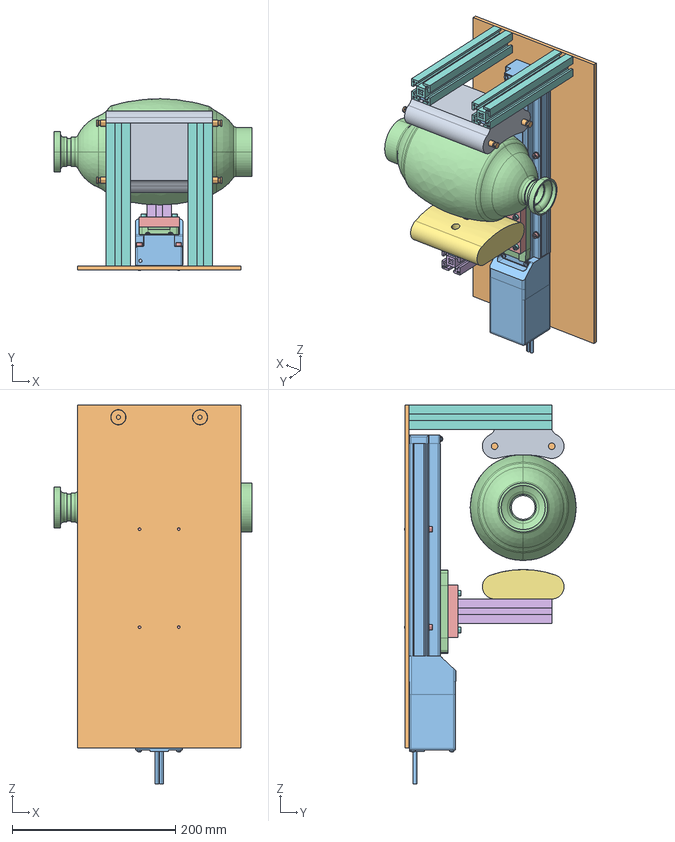
[picture p38: CAD file, 2020-04-15]
CAO/Dossier partage/rob-ceve-a00.stp
242.2 x 210.1 x 464.0 mm
ROB-CEVE-P01
LEFS25_150_0__BODY
LEFS25_0__TABLE
ROB-CEVE-P02
ROB-CEVE-P03
ROB-CEVE-P04
ROB-CEVE-P05 x 2
ROB-CEVE-P06
ROB-CEVE-P07 x 4
BOSCH_3842514929 x 7
AMBUBAG
ISO4762-M4X30-12_9 x 4
DIN125-1-B4 x 4
ISO4762-M5X20-12_9 x 7
ISO4762-M4X18-12_9 x 4
ISO4762-M8X14-12_9
ISO10642-M8X16-12_9 x 2
