GEVE-VENTILATOR/Mechanical-Design-/CAO/Respirateur V2/INNER_BRACKET_6.stp

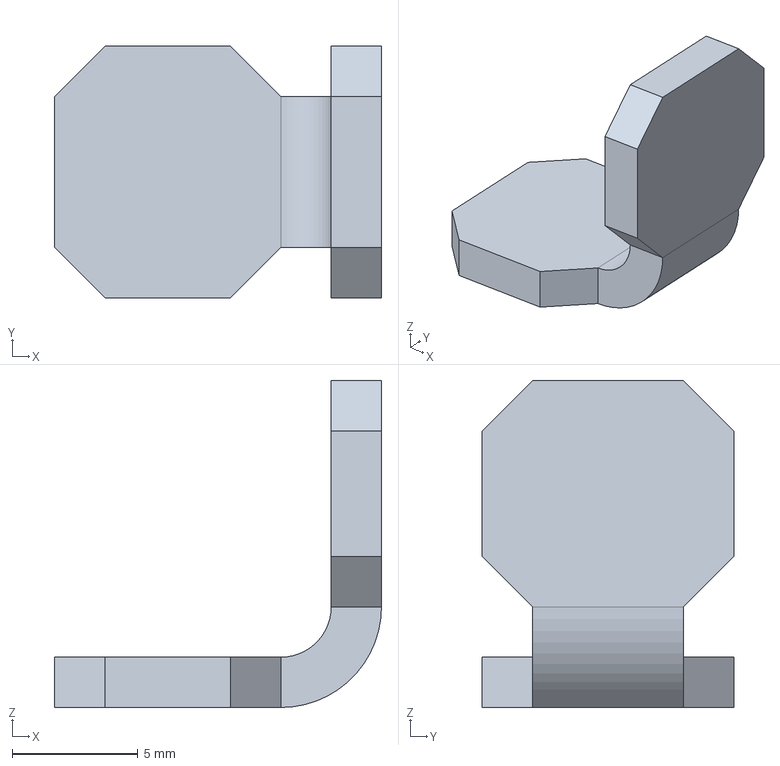
[picture p39: CAD file, 2021-05-17]
CAO/Respirateur V2/INNER_BRACKET_6.stp
13.0 x 10.0 x 13.0 mm
