GEVE-VENTILATOR/Mechanical-Design-/CAO/Dossier partage/rob-ceve-p06.stp

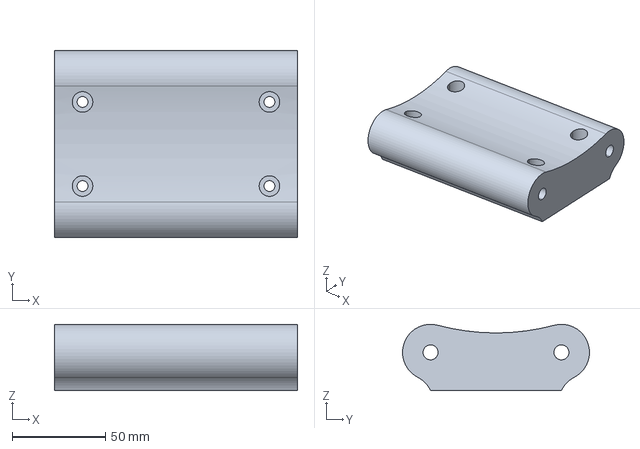
[picture p40: CAD file, 2020-04-15]
CAO/Dossier partage/rob-ceve-p06.stp
130.0 x 100.0 x 35.5 mm
