GEVE-VENTILATOR/Mechanical-Design-/CAO/Dossier partage/rob-ceve-p04.stp

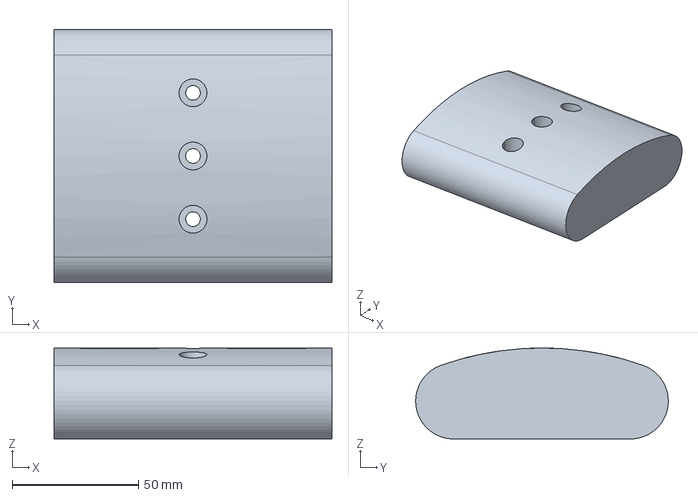
[picture p41: CAD file, 2020-04-15]
CAO/Dossier partage/rob-ceve-p04.stp
110.0 x 100.0 x 36.0 mm
