GEVE-VENTILATOR/Mechanical-Design-/CAO/Dossier partage/rob-ceve-p03.stp

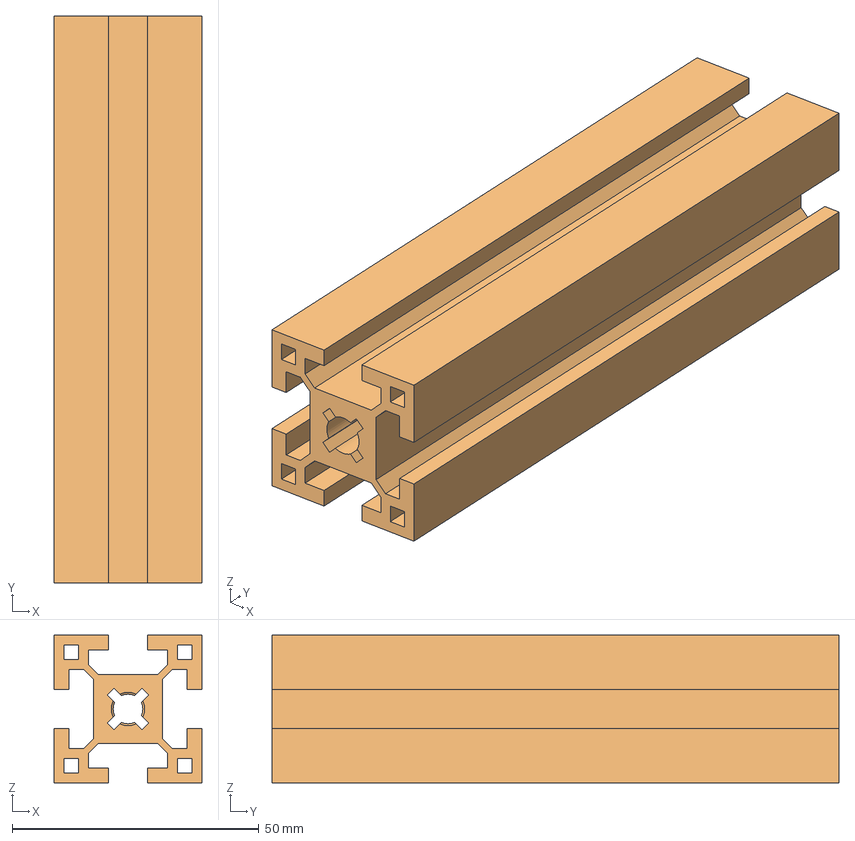
[picture p42: CAD file, 2020-04-15]
CAO/Dossier partage/rob-ceve-p03.stp
30.0 x 115.0 x 30.0 mm
