GEVE-VENTILATOR/Mechanical-Design-/CAO/Dossier partage/rob-ceve-p07.stp

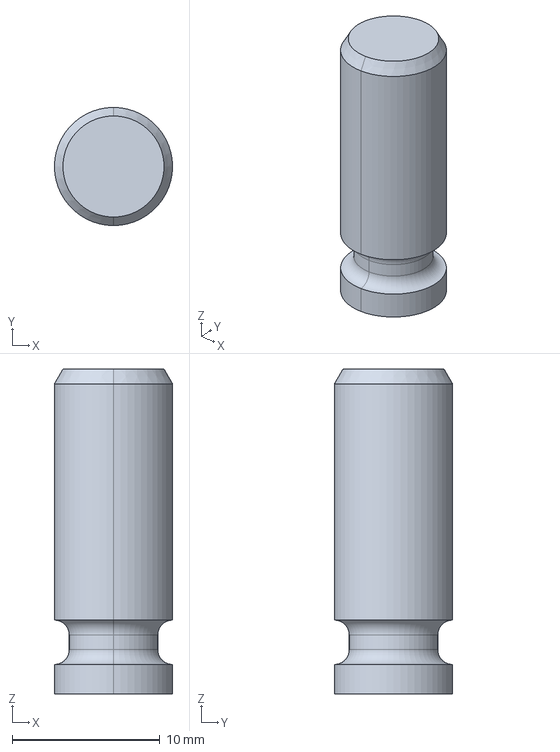
[picture p43: CAD file, 2020-04-15]
CAO/Dossier partage/rob-ceve-p07.stp
8.00 x 8.00 x 22.0 mm
