GEVE-VENTILATOR/Mechanical-Design-/CAO/Dossier partage/rob-ceve-p05.stp

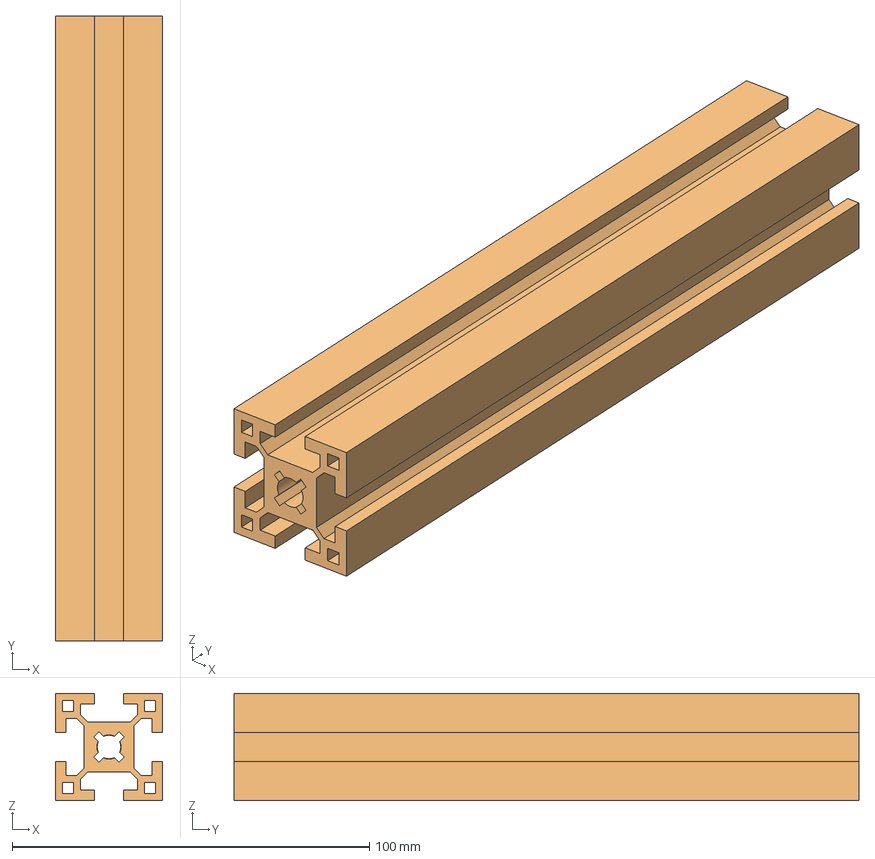
[picture p44: CAD file, 2020-04-15]
CAO/Dossier partage/rob-ceve-p05.stp
30.0 x 175.0 x 30.0 mm
