GEVE-VENTILATOR/Mechanical-Design-/CAO/Dossier partage/rob-ceve-p01.stp

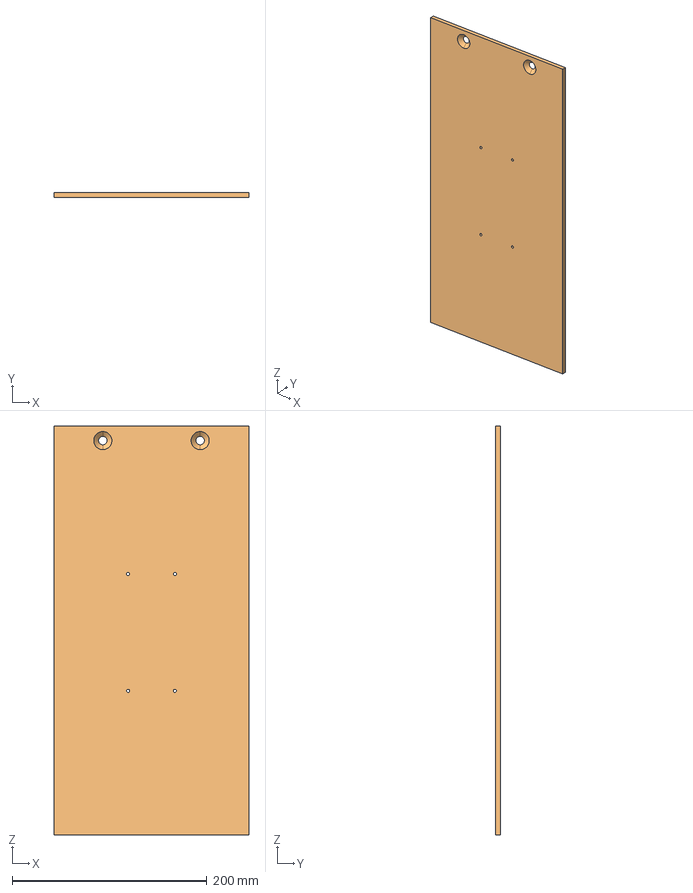
[picture p45: CAD file, 2020-04-15]
CAO/Dossier partage/rob-ceve-p01.stp
200.0 x 5.00 x 420.0 mm
