GEVE-VENTILATOR/Mechanical-Design-/(list of files, cad)

Other CAD files:
CAO/Dossier partage/rob-ceve-p25.stp
CAO/Dossier partage/rob-ceve-p22.stp
CAO/Respirateur V2/rob-ceve-p25.stp
CAO/Dossier partage/rob-ceve-p35.stp
CAO/Respirateur V2/rob-ceve-p22.stp
CAO/Respirateur V2/rob-ceve-p35.stp
CAO/Dossier partage/rob-ceve-p08.stl
CAO/Dossier partage/rob-ceve-p09.stl
CAO/Dossier partage/rob-ceve-p10.stl
CAO/Dossier partage/rob-ceve-p11.stl
CAO/Dossier partage/rob-ceve-p25.stl
CAO/Dossier partage/rob-ceve-p30.stl
CAO/Respirateur V2/rob-ceve-p08.stl
CAO/Respirateur V2/rob-ceve-p09.stl
CAO/Respirateur V2/rob-ceve-p10.stl
CAO/Respirateur V2/rob-ceve-p11.stl
CAO/Respirateur V2/rob-ceve-p20.dxf
CAO/Respirateur V2/rob-ceve-p21.dxf
CAO/Respirateur V2/rob-ceve-p22.dxf
CAO/Respirateur V2/rob-ceve-p23.dxf
CAO/Respirateur V2/rob-ceve-p24.dxf
CAO/Respirateur V2/rob-ceve-p25.stl
CAO/Respirateur V2/rob-ceve-p30.stl
CAO/ast0250204.stp
