GEVE-VENTILATOR/Mechanical-Design-/CAO/Dossier partage/rob-ceve-a01.pdf

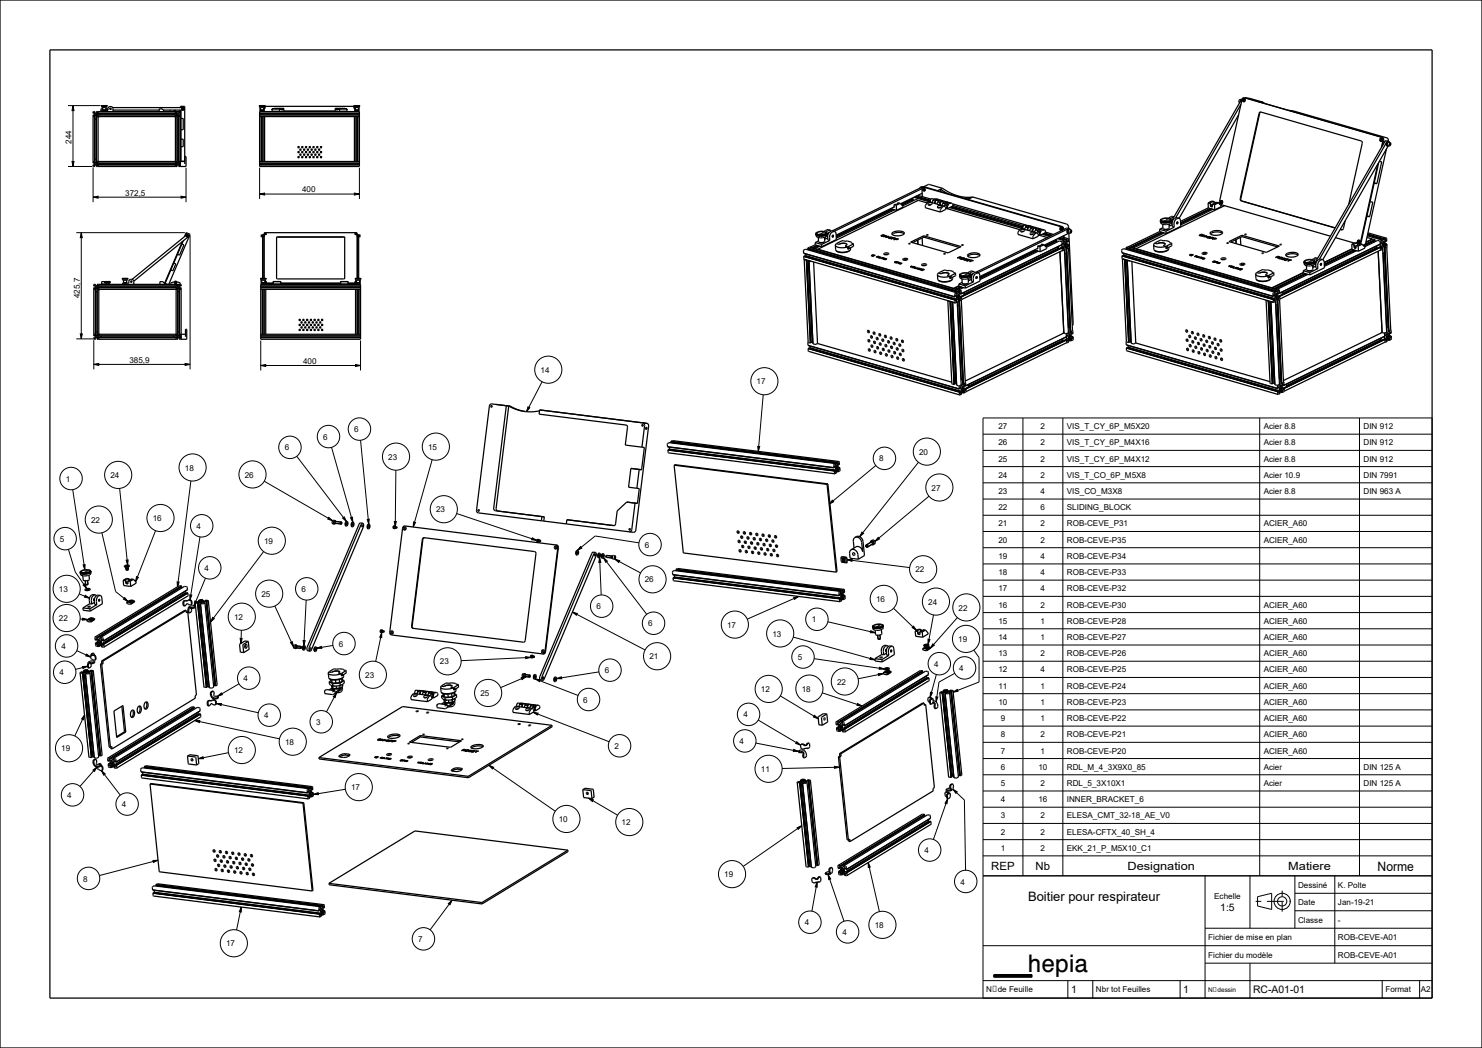
[picture p46: page 1]
hepia; N° de Feuille; Nbr tot Feuilles; N° dessin; Format A2; Fichier du modèle; ROB-CEVE-A01; Fichier de mise en plan; Classe; Echelle; Date; Jan-19-21; Dessiné K. Polte; REP; Designation; Matiere; Norme; EKK_21_P_M5X10_C1; ELESA-CFTX_40_SH_4; ELESA_CMT_32-18_AE_V0; INNER_BRACKET_6; RDL_5_3X10X1; Acier; DIN 125 A; RDL_M_4_3X9X0_85; ROB-CEVE-P20; ACIER_A60; ROB-CEVE-P21; ROB-CEVE-P22; ROB-CEVE-P23; ROB-CEVE-P24; ROB-CEVE-P25; ROB-CEVE-P26; ROB-CEVE-P27; ROB-CEVE-P28; ROB-CEVE-P30; ROB-CEVE-P32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

Boitier pour respirateur
