GEVE-VENTILATOR/Mechanical-Design-/CAO/Dossier partage/rob-ceve-p21.pdf

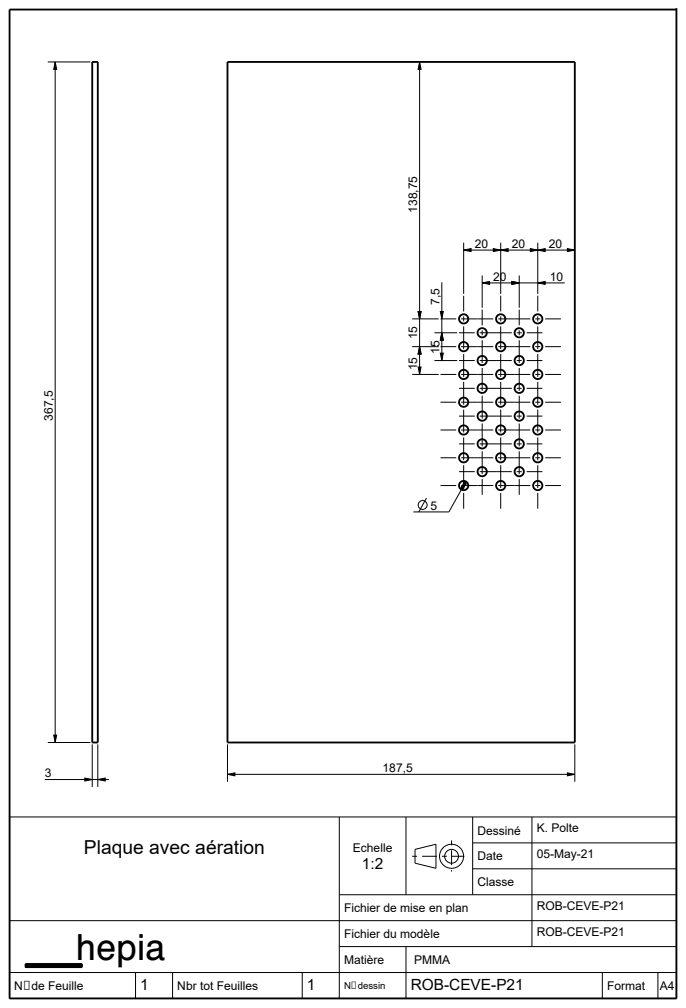
[picture p47: page 1]
187,5 ³⁶⁷,5

Plaque avec aération | Echelle 1:2 | | Dessiné | K. Polte

Date | 05-May-21

Classe

Fichier de mise en plan | | | ROB-CEVE-P21

hepia | Fichier du modèle | | | ROB-CEVE-P21

Matière | PMMA

N° de Feuille | 1 | Nbr tot Feuilles | 1 | N° dessin | ROB-CEVE-P21 | Format | A4
