GEVE-VENTILATOR/Mechanical-Design-/CAO/Dossier partage/rob-ceve-p22.pdf

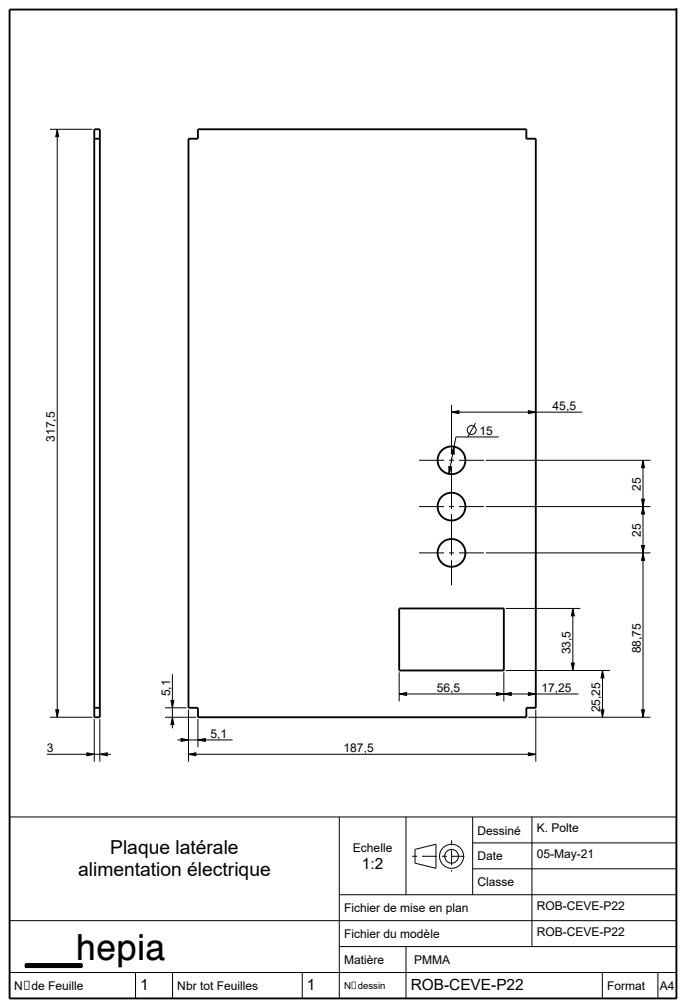
[picture p48: page 1]

Plaque latérale alimentation électrique | Echelle 1:2 | Dessiné | K. Polte
Date Classe | 05-May-21
hepia | Fichier du modèle | ROB-CEVE-P22

Fichier de mise en plan | ROB-CEVE-P22

Matière | PMMA

N° de Feuille | 1 | Nbr tot Feuilles | 1 | N° dessin | ROB-CEVE-P22 | Format | A4
