GEVE-VENTILATOR/Mechanical-Design-/CAO/Dossier partage/rob-ceve-p23.pdf

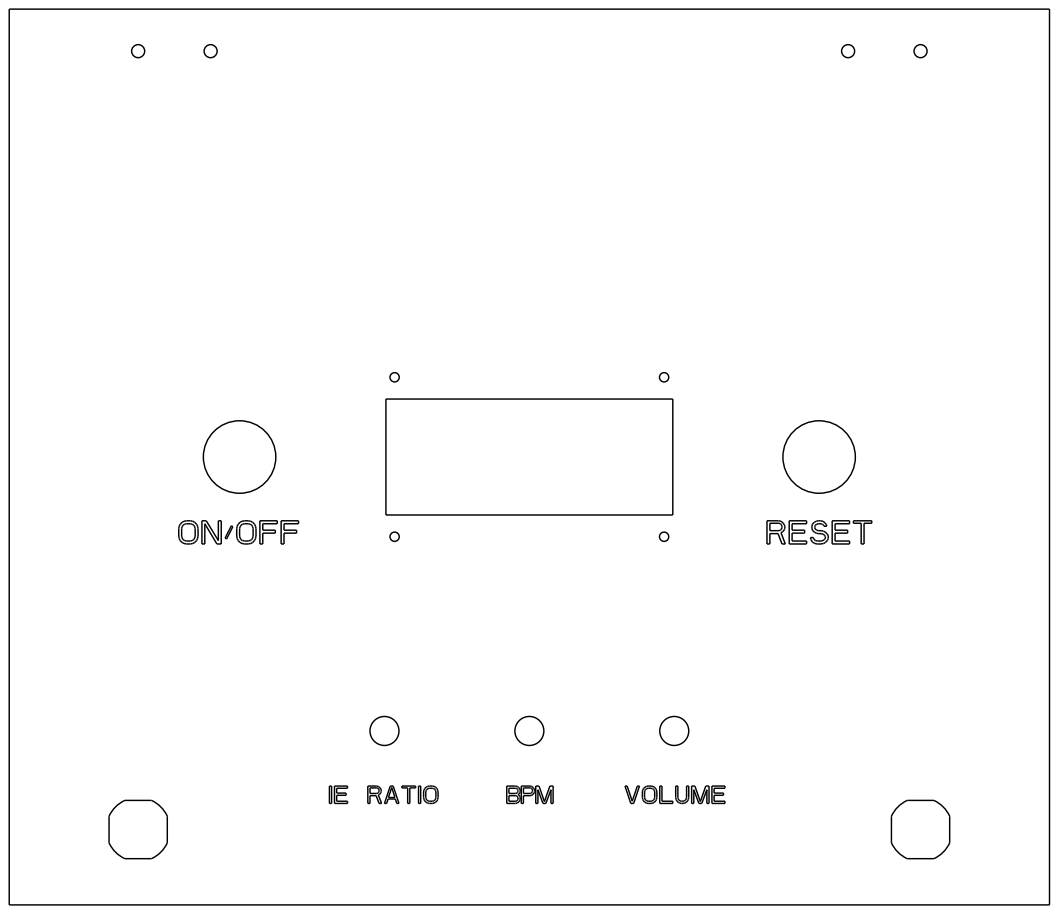
[picture p49: page 1]

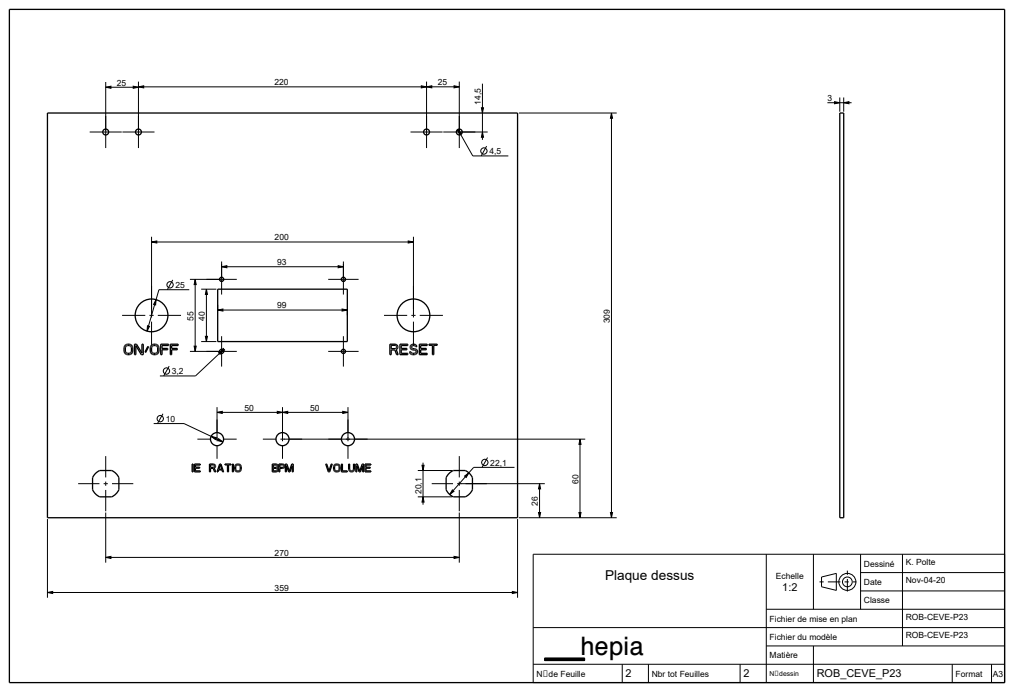
[picture p50: page 2]

Plaque dessus | Echelle 1:2 | | Dessiné | K. Polte

Date | Nov-04-20

Classe

Fichier de mise en plan | | | ROB-CEVE-P23

hepia | Fichier du modèle | | | ROB-CEVE-P23

Matière

N° de Feuille | 2 | Nbr tot Feuilles | 2 | N° dessin | ROB_CEVE_P23 | Format | A3
