GEVE-VENTILATOR/Mechanical-Design-/CAO/Dossier partage/rob-ceve-p26.pdf

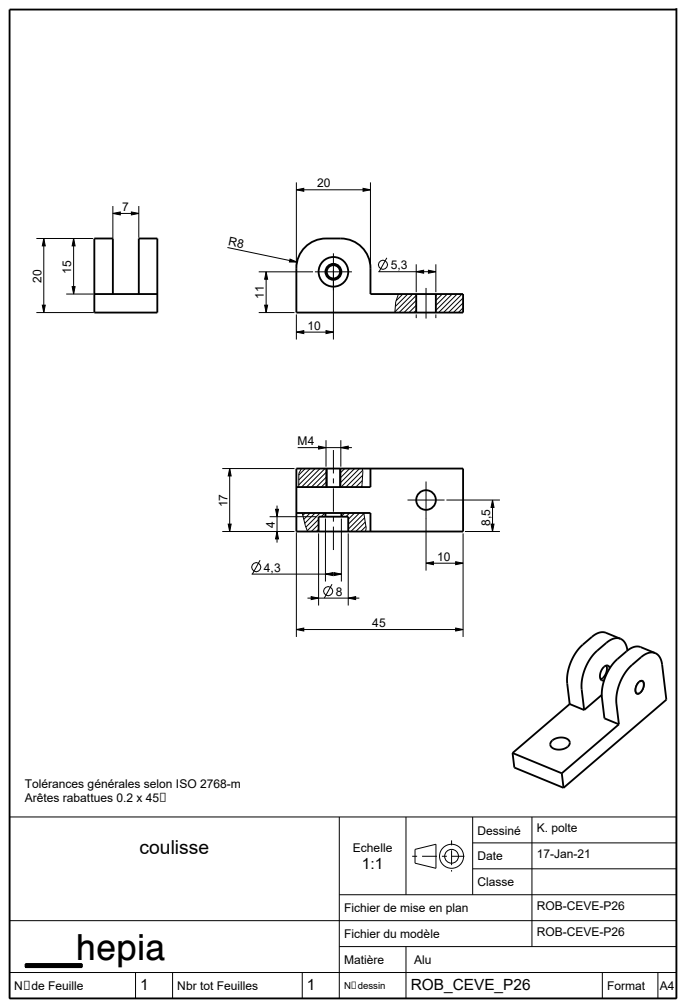
[picture p51: page 1]

Tolérances générales selon ISO 2768-m
Arêtes rabattues 0.2 x 45°

coulisse | Echelle 1:1 | | Dessiné | K. polte

Date | 17-Jan-21

Classe

Fichier de mise en plan | | | ROB-CEVE-P26

hepia | Fichier du modèle | | | ROB-CEVE-P26

Matière | Alu

N° de Feuille | 1 | Nbr tot Feuilles | 1 | N° dessin | ROB_CEVE_P26 | Format | A4
