GEVE-VENTILATOR/Mechanical-Design-/CAO/Dossier partage/rob-ceve-p27.pdf

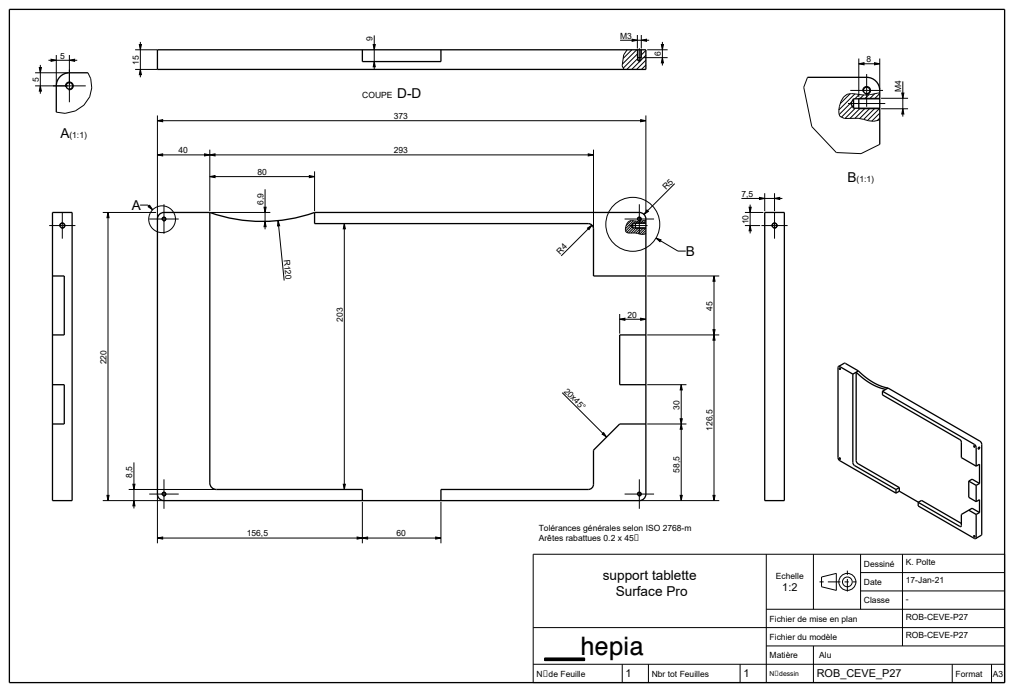
[picture p52: page 1]
COUPE D-D

Tolérances générales selon ISO 2768-m
Arêtes rabattues 0.2 x 45°

support tablette Surface Pro | Echelle 1:2 | | Dessiné | K. Polte

Date | 17-Jan-21

Classe | -

Fichier de mise en plan | | | ROB-CEVE-P27

hepia | Fichier du modèle | | | ROB-CEVE-P27

Matière | Alu

N° de Feuille | 1 | Nbr tot Feuilles | 1 | N° dessin | ROB_CEVE_P27 | Format | A3
