GEVE-VENTILATOR/Mechanical-Design-/CAO/Dossier partage/rob-ceve-p28.pdf

B

A

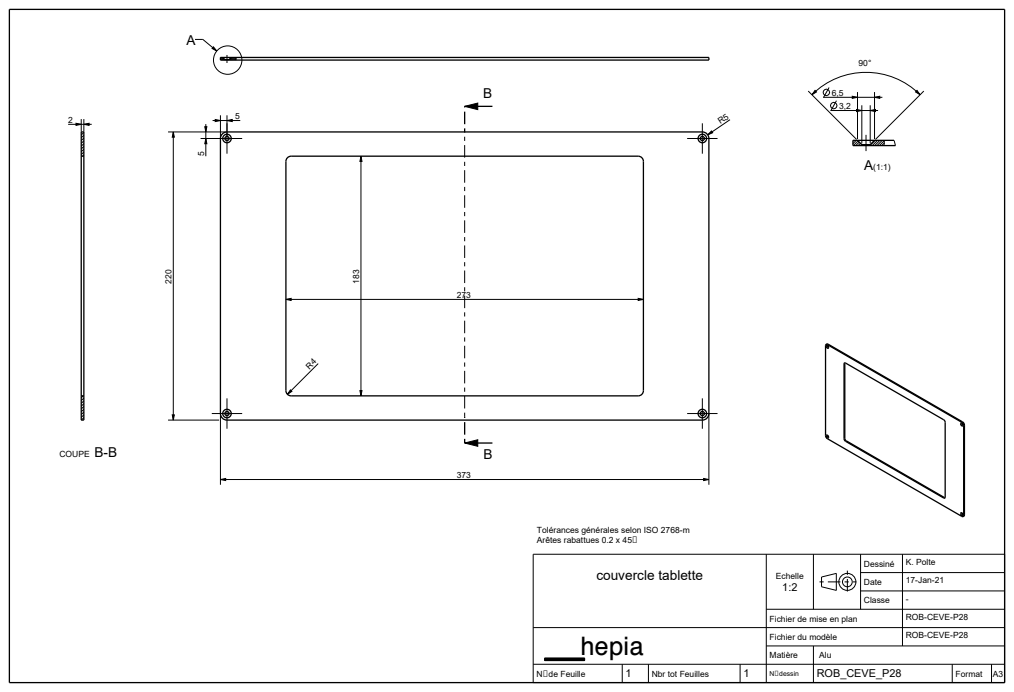
[picture p53: page 1]
COUPE B-B

Tolérances générales selon ISO 2768-m
Arêtes rabattues 0.2 x 45°

couvercle tablette | Echelle 1:2 | | Dessiné | K. Polte

Date | 17-Jan-21

Classe | -

Fichier de mise en plan | | | ROB-CEVE-P28

hepia | Fichier du modèle | | | ROB-CEVE-P28

Matière | Alu

N° de Feuille | 1 | Nbr tot Feuilles | 1 | N° dessin | ROB_CEVE_P28 | Format | A3
