GEVE-VENTILATOR/Mechanical-Design-/CAO/Dossier partage/rob-ceve-p30.pdf

A

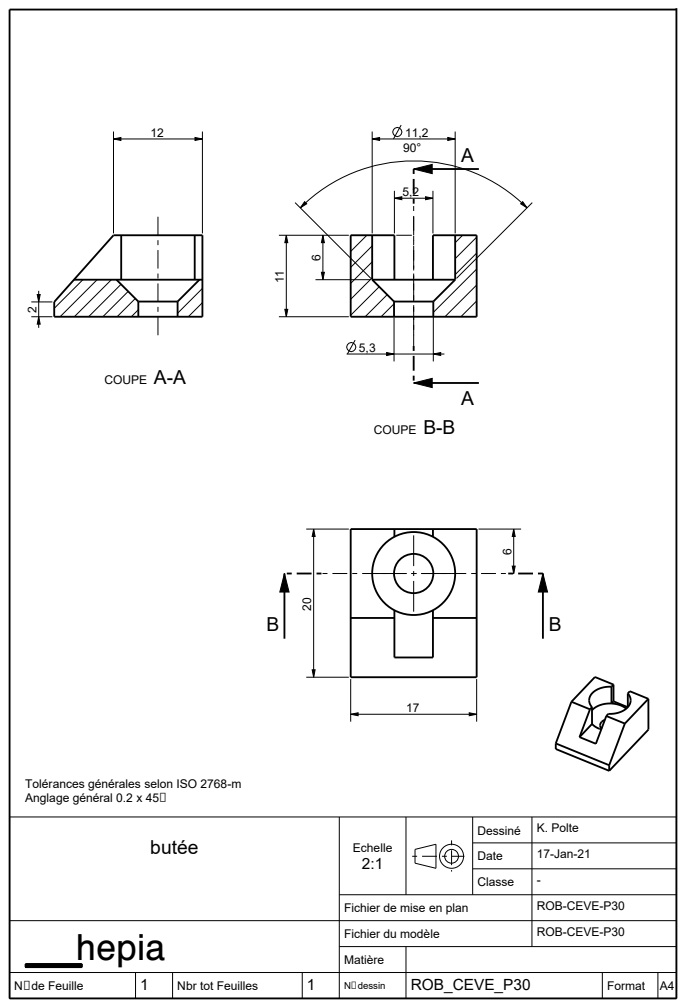
[picture p54: page 1]
COUPE B-B; COUPE A-A

Tolérances générales selon ISO 2768-m
Anglage général 0.2 x 45°

butée | Echelle 2:1 | | Dessiné | K. Polte

Date | 17-Jan-21

Classe | -

Fichier de mise en plan | | | ROB-CEVE-P30

hepia | Fichier du modèle | | | ROB-CEVE-P30

Matière

N° de Feuille | 1 | Nbr tot Feuilles | 1 | N° dessin | ROB_CEVE_P30 | Format | A4
