GEVE-VENTILATOR/Mechanical-Design-/CAO/Dossier partage/rob-ceve-p31.pdf

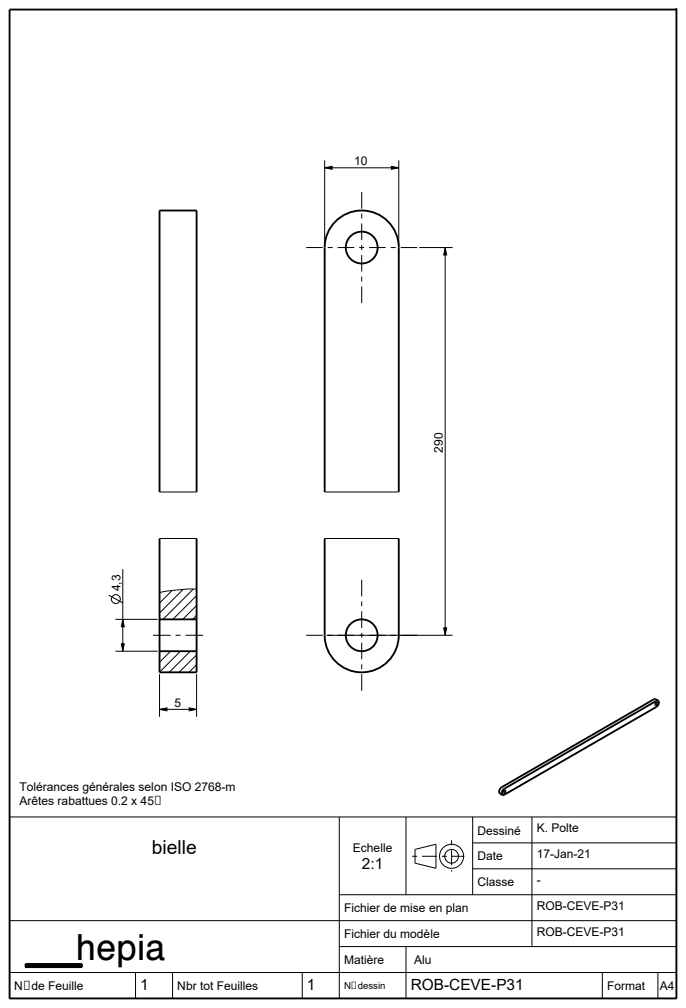
[picture p55: page 1]

Tolérances générales selon ISO 2768-m
Arêtes rabattues 0.2 x 45°

bielle | Echelle 2:1 | | Dessiné | K. Polte

Date | 17-Jan-21

Classe | -

Fichier de mise en plan | | | ROB-CEVE-P31

hepia | Fichier du modèle | | | ROB-CEVE-P31

Matière | Alu

N° de Feuille | 1 | Nbr tot Feuilles | 1 | N° dessin | ROB-CEVE-P31 | Format | A4
