GEVE-VENTILATOR/Mechanical-Design-/CAO/Dossier partage/rob-ceve-p32.pdf

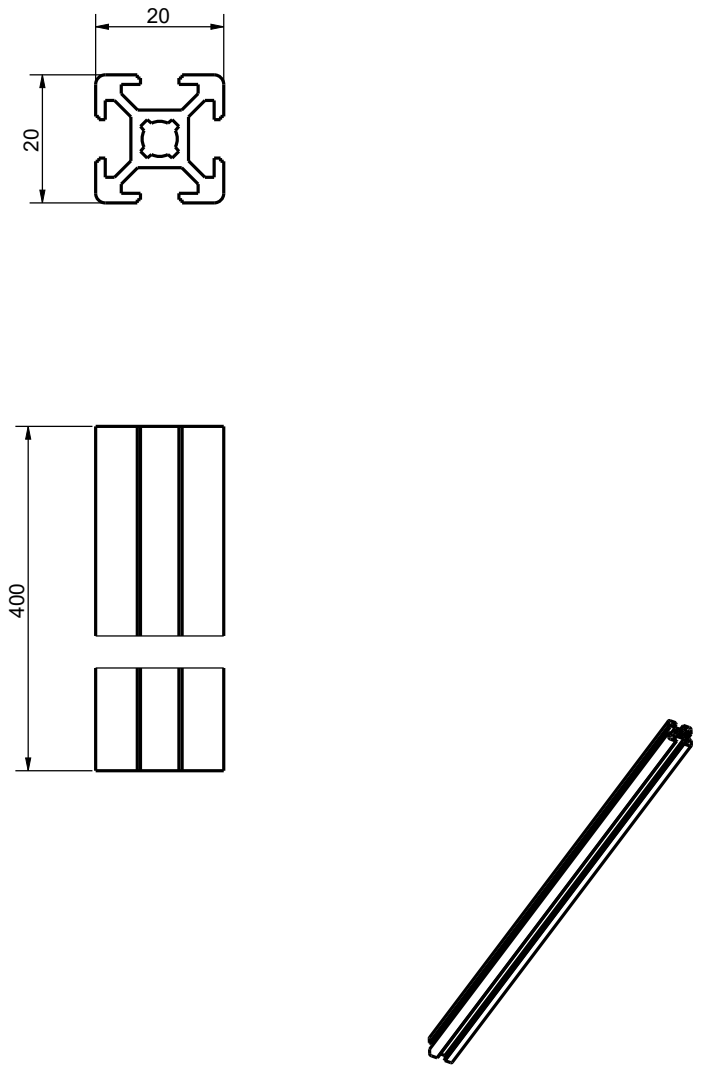
[picture p56: page 1]

Profilé Bosch 20x20 longueur : 400 | Echelle 1:1 | Dessiné | K. Polte
Date Classe | 05-May-21
hepia | Fichier du modèle | ROB-CEVE-P32

Fichier de mise en plan | ROB-CEVE-P32

Matière | Bosch 20x20 rèf : 3842992888/400

N° de Feuille | 1 | Nbr tot Feuilles | 1 | N° dessin | ROB-CEVE-P32 | Format | A4
