GEVE-VENTILATOR/Mechanical-Design-/CAO/Dossier partage/rob-ceve-p33.pdf

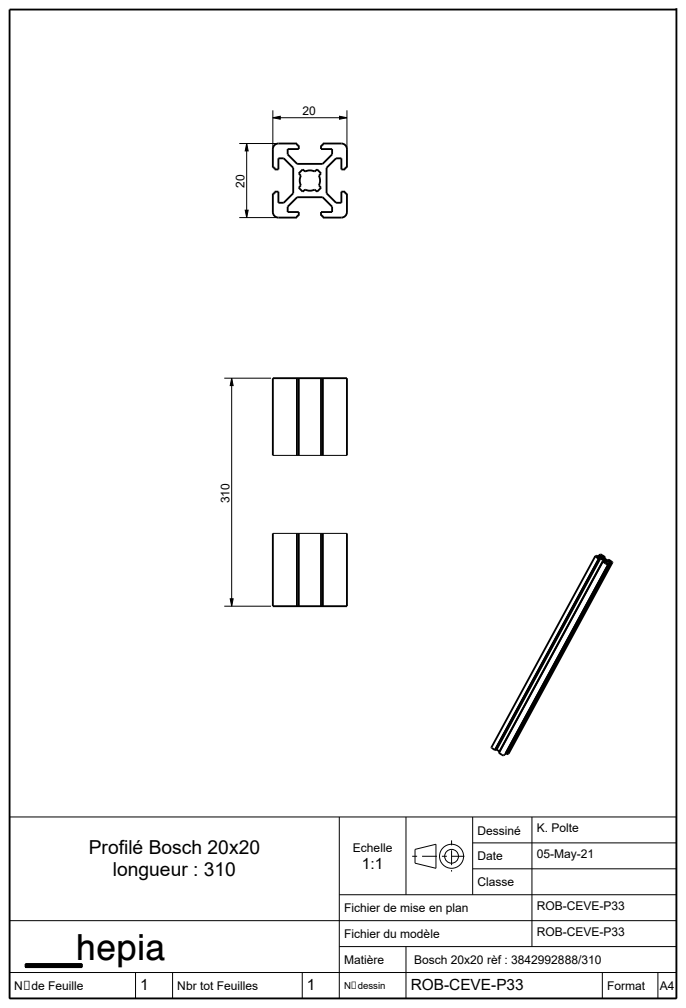
[picture p57: page 1]

Profilé Bosch 20x20 longueur : 310 | Echelle 1:1 | Dessiné | K. Polte
Date Classe | 05-May-21
hepia | Fichier du modèle | ROB-CEVE-P33

Fichier de mise en plan | ROB-CEVE-P33

Matière | Bosch 20x20 rèf : 3842992888/310

N° de Feuille | 1 | Nbr tot Feuilles | 1 | N° dessin | ROB-CEVE-P33 | Format | A4
