GEVE-VENTILATOR/Mechanical-Design-/CAO/Dossier partage/rob-ceve-p34.pdf

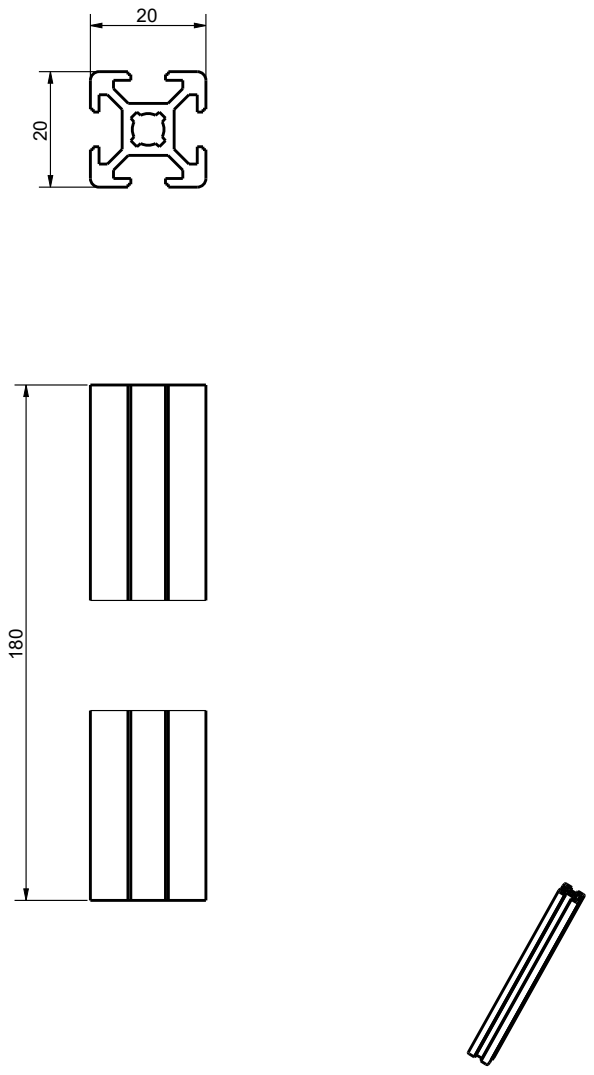
[picture p58: page 1]

Profilé Bosch 20x20 longueur : 180 | Echelle 1:2 | Dessiné | K. Polte
Date Classe | 05-May-21
hepia | Fichier du modèle | ROB-CEVE-P34

Fichier de mise en plan | ROB-CEVE-P34

Matière | Bosch 20x20 rèf : 3842992888/180

N° de Feuille | 1 | Nbr tot Feuilles | 1 | N° dessin | ROB-CEVE-P34 | Format | A4
