GEVE-VENTILATOR/Mechanical-Design-/CAO/Dossier partage/rob-ceve-p35.pdf

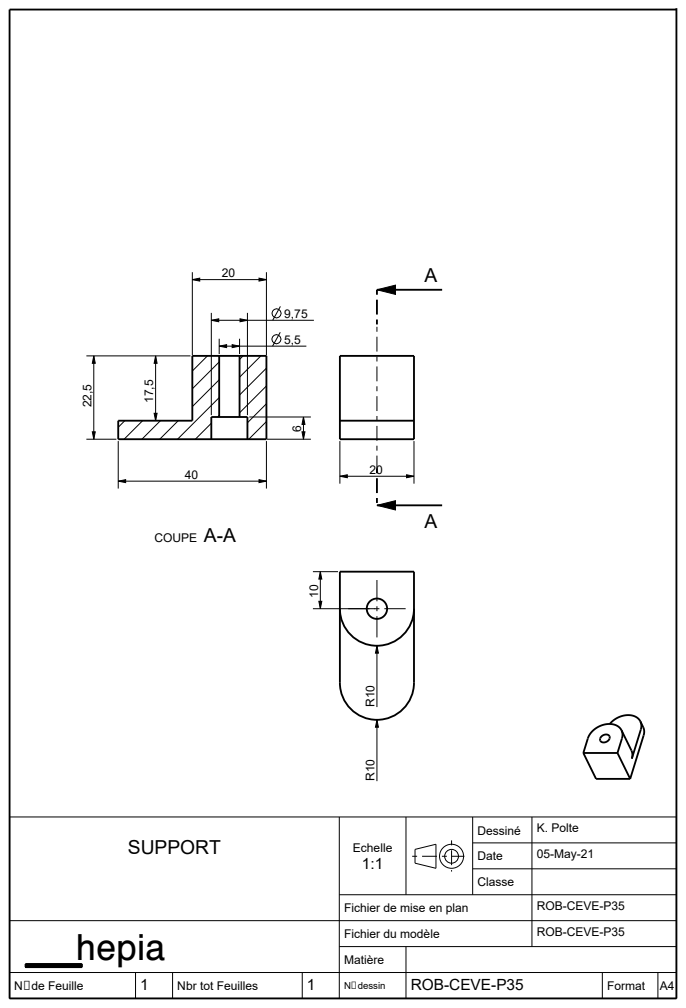
[picture p59: page 1]
COUPE A-A

SUPPORT | Echelle 1:1 | | Dessiné | K. Polte

Date | 05-May-21

Classe

Fichier de mise en plan | | | ROB-CEVE-P35

hepia | Fichier du modèle | | | ROB-CEVE-P35

Matière

N° de Feuille | 1 | Nbr tot Feuilles | 1 | N° dessin | ROB-CEVE-P35 | Format | A4
