GEVE-VENTILATOR/Mechanical-Design-/(list of files, drawings)

Other design files:
PCB_Project/Composants_Supplementaire.SchDoc
PCB_Project/GEVE_lib.PcbLib
PCB_Project/GEVE_lib.SchLib
PCB_Project/PCB_GEVE.PcbDoc
PCB_Project/PCB_Project.PrjPcb
PCB_Project/Schema_GEVE.SchDoc
