GEVE-VENTILATOR/Mechanical-Design-/(commit log)

2020-04-15 First commit of CAD drawings and files
    I created subfolders for more clarity
    [rob-ceve-a00.stp, rob-ceve-p01.stp, rob-ceve-p02.stp, rob-ceve-p03.stp, rob-ceve-p04.stp, rob-ceve-p05.stp, rob-ceve-p06.stp, rob-ceve-p07.stp]
2021-05-17 added latest version of the mechanical and pcb design as provided by the team hepia
    [rob-ceve-a00.stp, rob-ceve-p01.stp, rob-ceve-p02.stp, rob-ceve-p03.stp, rob-ceve-p04.stp, rob-ceve-p05.stp, rob-ceve-p06.stp, rob-ceve-p07.stp]
2021-05-17 added list of components, schematics and PCB project ov the V2 ventilator
    [CLAMPING_LEVER.stp, Composants_Supplementaire.SchDoc, ELESA-CFTX_40_SH_4.stp, ELESA_CMT_32-18_AE_V0.stp, GEVE_lib.PcbLib, GEVE_lib.SchLib, INNER_BRACKET_6.stp, LCD2004.stp]
