GEVE-VENTILATOR/Mechanical-Design-/(notices)

Notices in the files:
CAO/Respirateur V2/ELESA_CMT_32-18_AE_V0.stp:
FILE_NAME( 'p:/temp/worker_591/temp/exporttempdir_3540_345_7II10/format_0/Latches with fold-away knob CMT.32-18 AE-V0(1).stp', '2020-09-02T12:28:30', ( 'License CC BY-ND 4.0' ), ( 'CADENAS' ), ' ', 'PARTsolutions', ' ' );
CAO/Respirateur V2/ELESA-CFTX_40_SH_4.stp:
FILE_NAME( 'p:/temp/worker_921/temp/exporttempdir_4272_209_dSyWC/format_0/Hinges CFTX.40 SH-4(0).stp', '2020-09-03T12:40:34', ( 'License CC BY-ND 4.0' ), ( 'CADENAS' ), ' ', 'PARTsolutions', ' ' );
